cyberjak2k/micromake.github.io/docs/delta/2/2.md

---
title: 下部组装
---

## 0.注意事项

!!! warning "螺丝固定"
    螺丝固定打印件时，不要拧的过紧，以免拧坏打印件。

!!! info "嵌入螺母"
    部分打印件需借助烙铁压入<strong>滚花螺母</strong>：
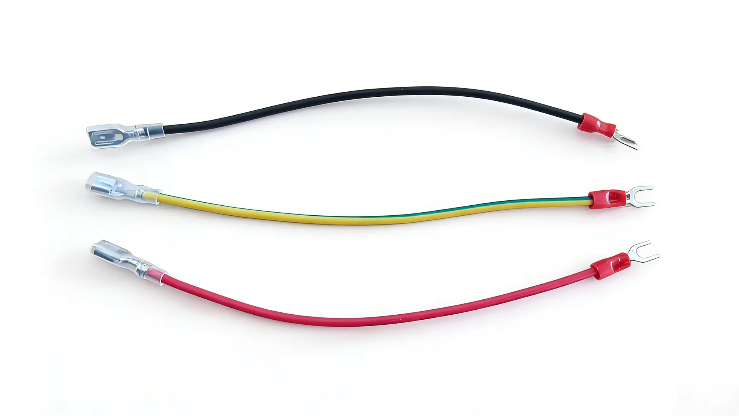
[picture p1: docs/delta/7/1.webp]
    

## 1.下装饰件

### 所需物料

1.脚垫 * 3
   

2.船型螺母20型-M3 * 6
   

3.M5*16 杯头螺丝 * 3
   

4.M3*10 杯头螺丝 * 6
   

### 打印零件

1.[下脚件装饰件] * 3
[下脚件装饰件]: dy1.stl
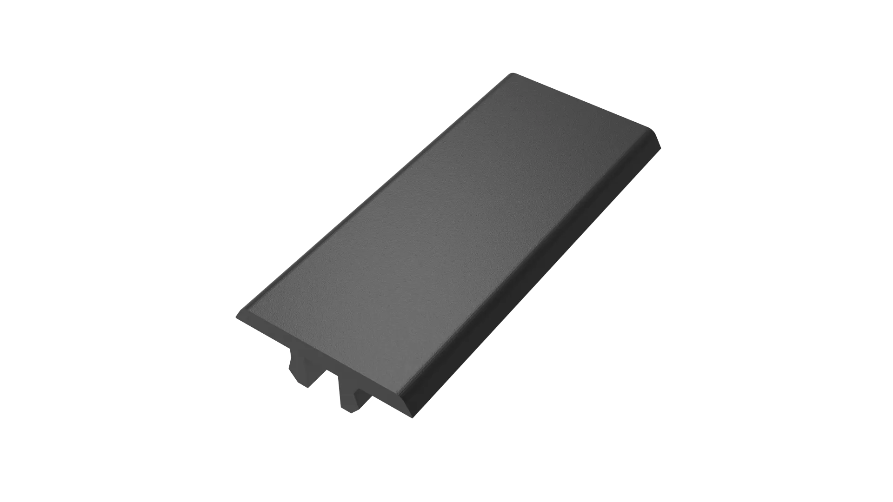
[picture p2: docs/delta/7/dy1.webp]
   

### 组装流程

1.将<strong>M5*16 杯头螺丝</strong>穿过<strong>脚垫</strong>拧入到<strong>下脚件装饰件</strong>中。
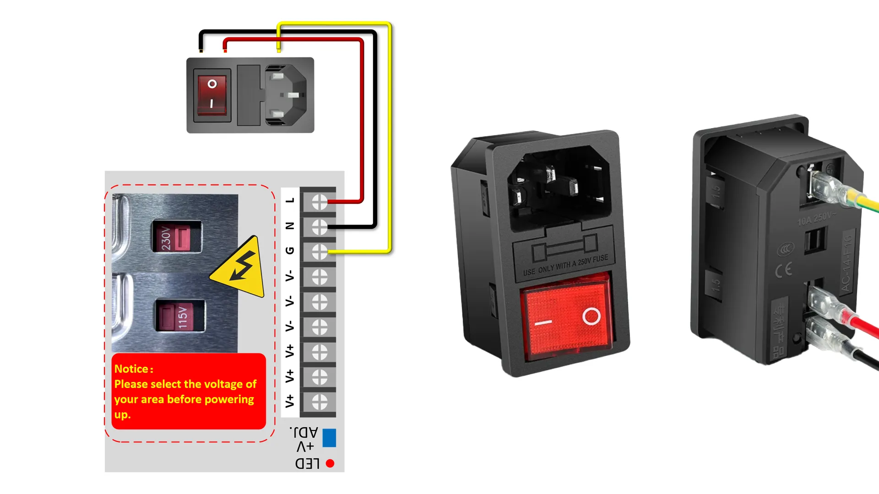
[picture p3: docs/delta/7/2.webp]
   

2.将<strong>M3*10 杯头螺丝</strong>穿过<strong>下脚件装饰件</strong>并套上<strong>船型螺母20型-M3</strong>。
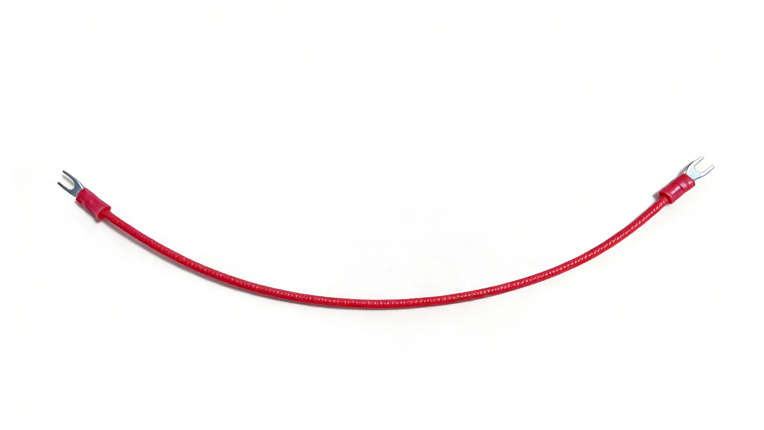
[picture p4: docs/delta/7/3.webp]
   

3.<strong>M3*10 杯头螺丝</strong>拧上即可，无需拧紧。
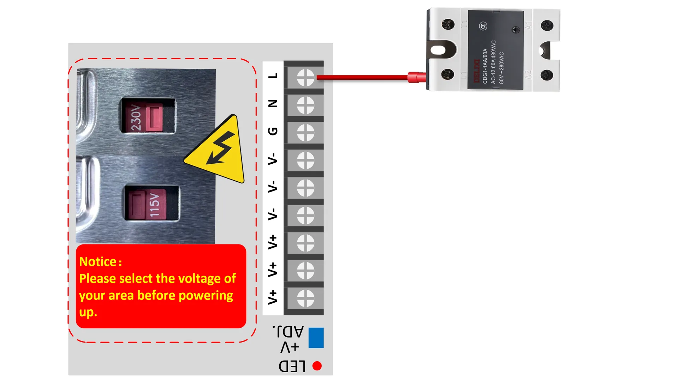
[picture p5: docs/delta/7/4.webp]
   

4.固定到<strong>短铝型材</strong>上。
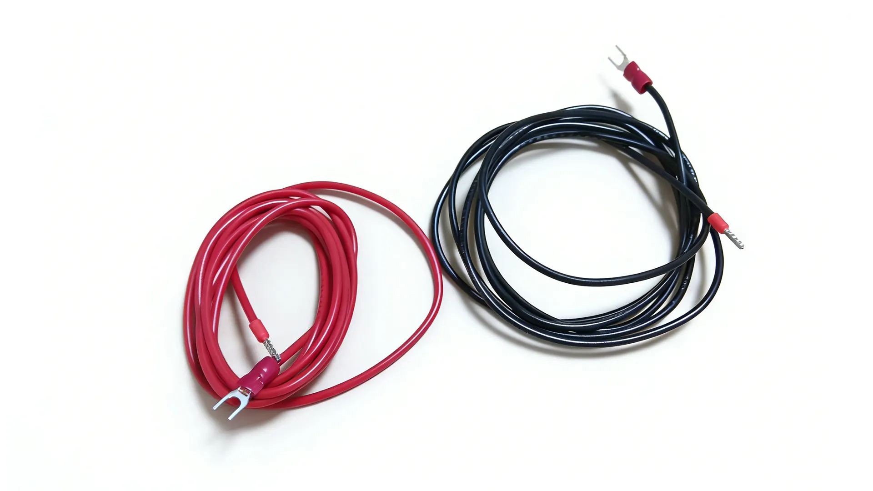
[picture p6: docs/delta/7/5.webp]
   

5.注意<strong>船型螺母20型-M3</strong>的位置，应卡在型材上，不要拧的过紧，以免拧坏<strong>下脚件装饰件</strong>。
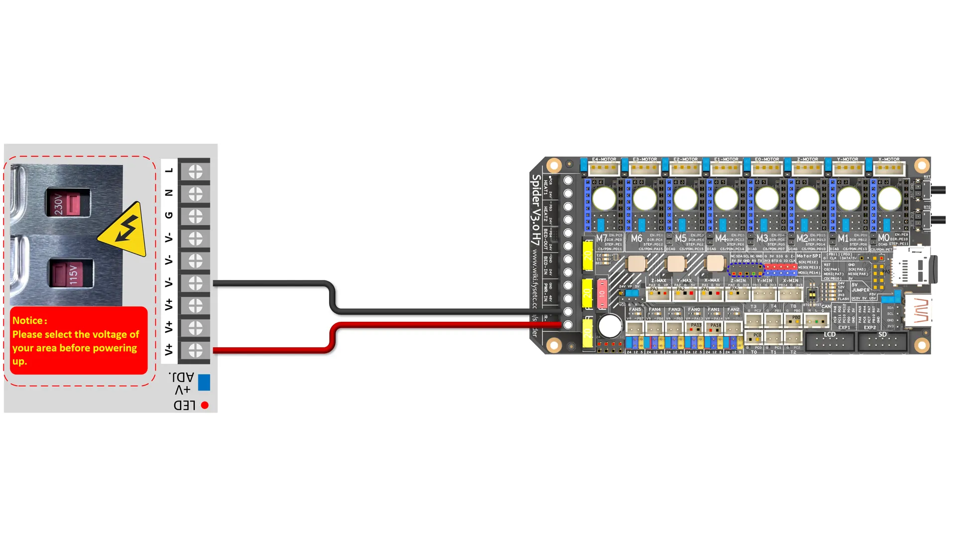
[picture p7: docs/delta/7/6.webp]
   

6.另外两组安装方法相同。
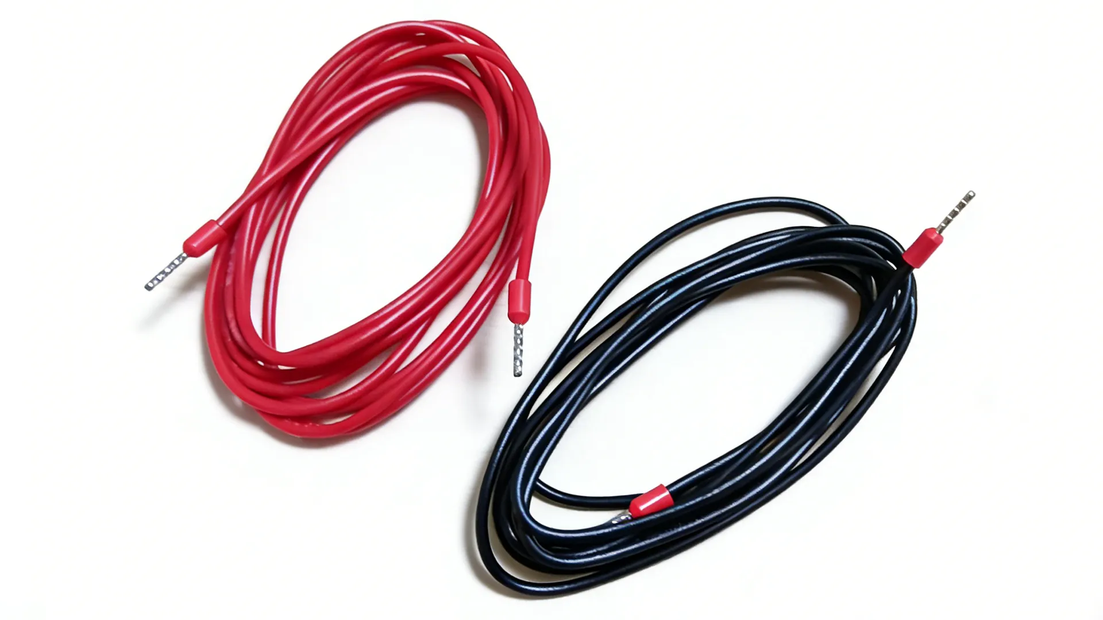
[picture p8: docs/delta/7/7.webp]
   

## 2.左侧裙边

### 所需物料

1.M3*8 沉头螺丝 * 6
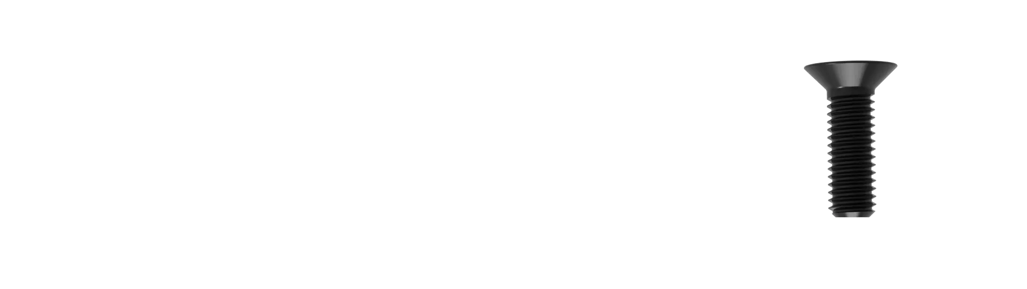
[picture p9: docs/delta/7/M3X8.webp]
   

2.滚花螺母 * 3
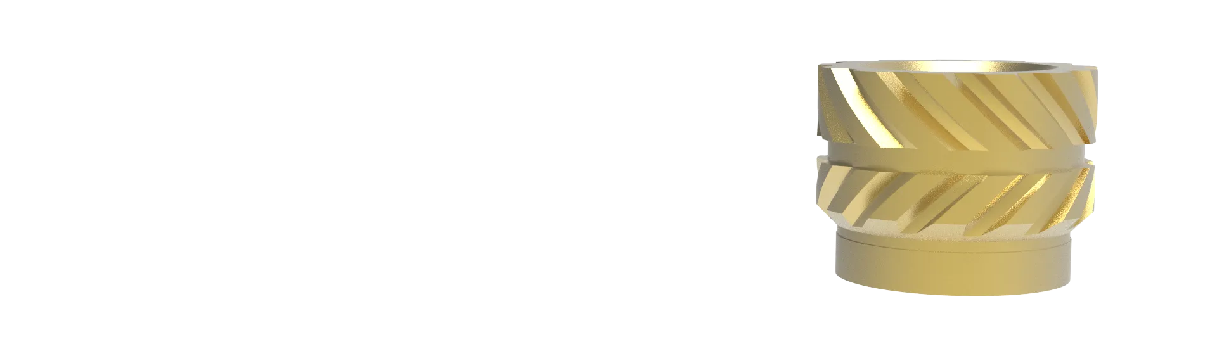
[picture p10: docs/delta/7/tlm.webp]
   
   
3.船型螺母20型-M3 * 6
   

### 打印零件

1.[左裙边打印件]  * 3
[左裙边打印件]: dy2.stl
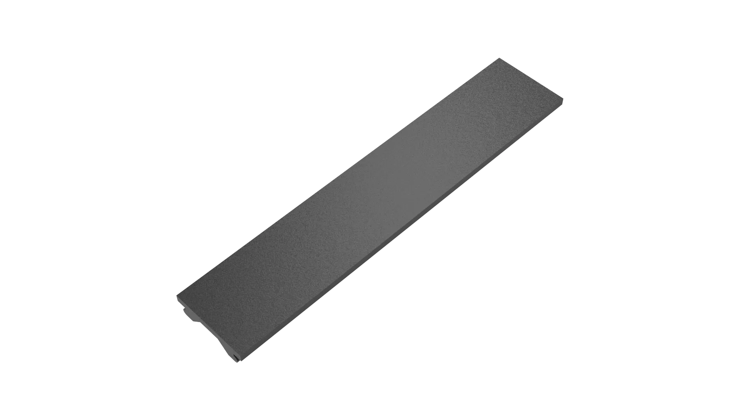
[picture p11: docs/delta/7/dy2.webp]
   

### 组装流程

1.使用烙铁将<strong>滚花螺母</strong>压入<strong>左裙边打印件</strong>中。
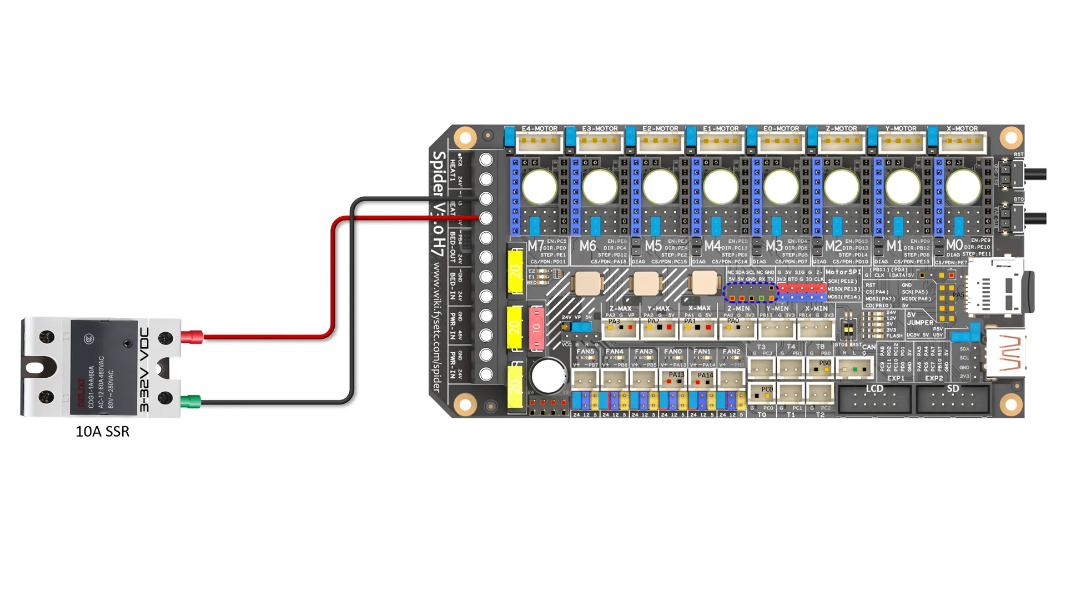
[picture p12: docs/delta/7/8.webp]
   

2.将<strong>M3*8 沉头螺丝</strong>穿过<strong>左裙边打印件</strong>并套上<strong>船型螺母20型-M3</strong>。
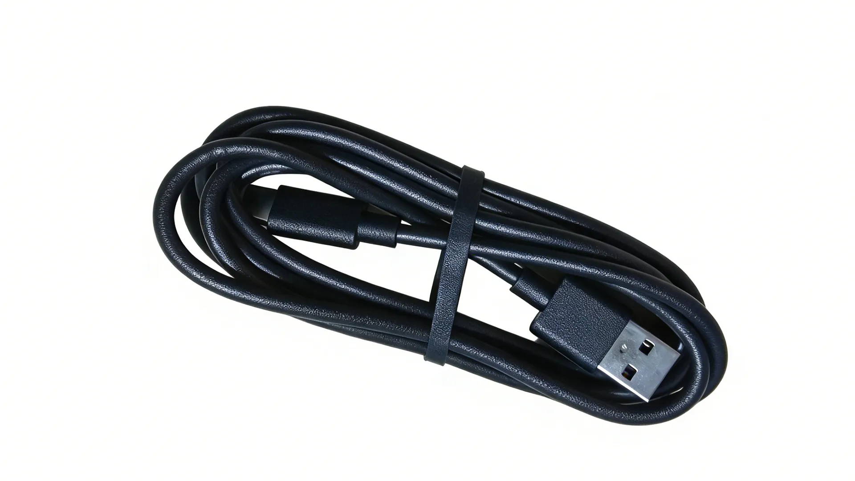
[picture p13: docs/delta/7/9.webp]
   

3.<strong>M3*8 沉头螺丝</strong>拧上即可，无需拧紧。
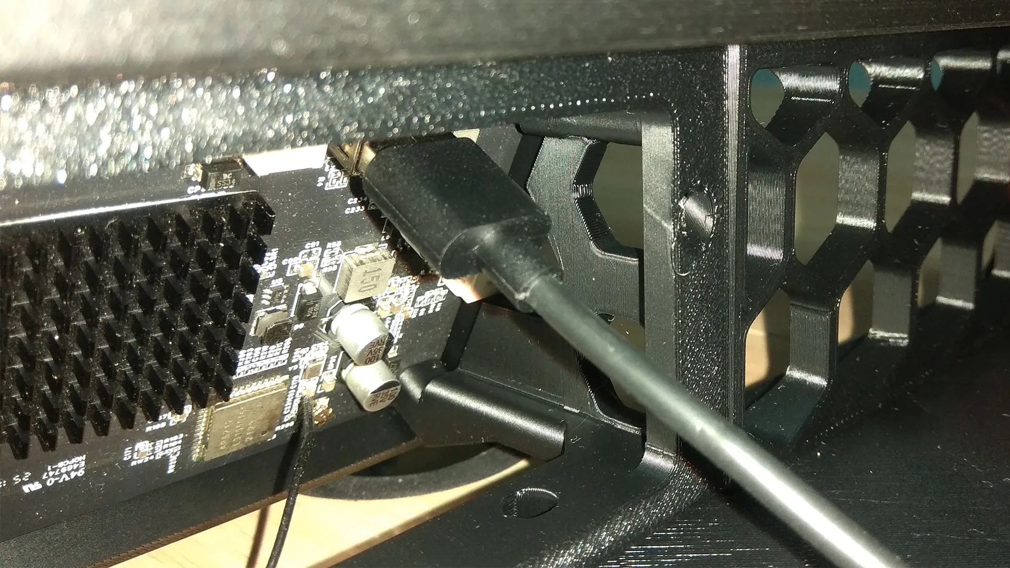
[picture p14: docs/delta/7/10.webp]
   

4.固定到<strong>短铝型材</strong>上。
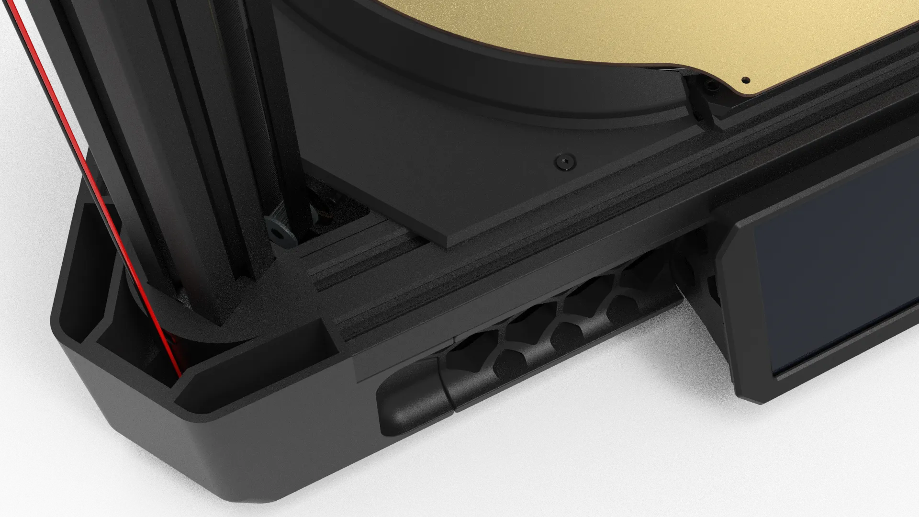
[picture p15: docs/delta/7/11.webp]
   

5.另外两组安装方法相同。
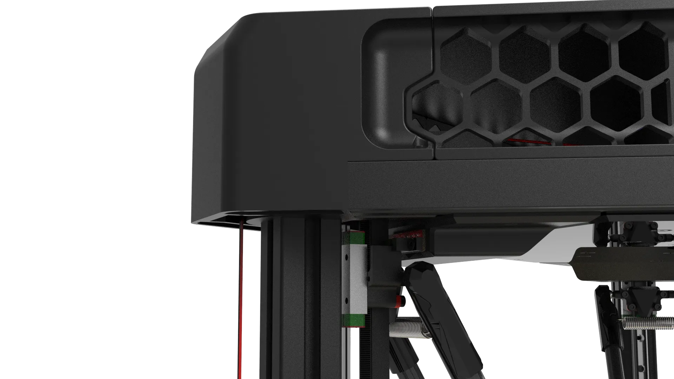
[picture p16: docs/delta/7/12.webp]
   
  
## 3.电源开关

### 所需物料

1.电源开关 * 1
   

2.M3*8 沉头螺丝 * 2
   

3.滚花螺母 * 1
   

4.船型螺母20型-M3 * 2
   

### 打印零件

1.[右裙边开关打印件] * 1
[右裙边开关打印件]: dy3.stl
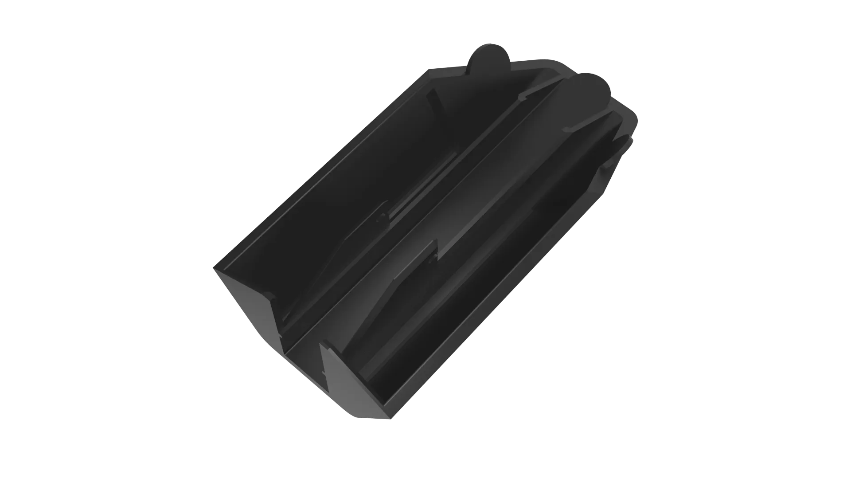
[picture p17: docs/delta/7/dy3.webp]
   

### 组装流程

1.使用烙铁将<strong>滚花螺母</strong>压入<strong>右裙边开关打印件</strong>中。
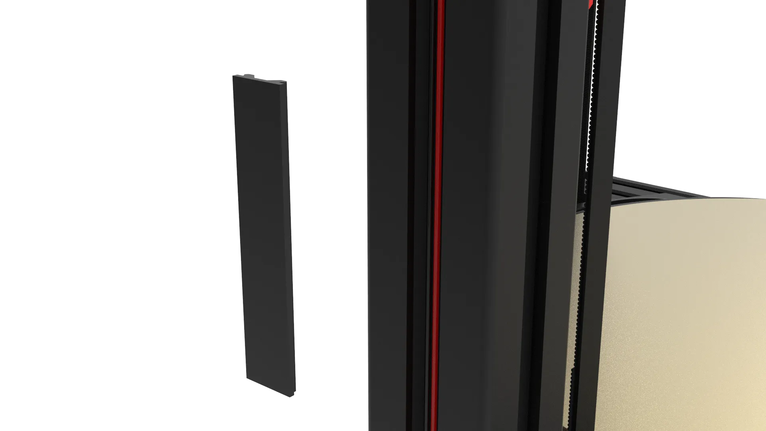
[picture p18: docs/delta/7/13.webp]
   

2.将<strong>电源开关</strong>装入<strong>右裙边开关打印件</strong>中。
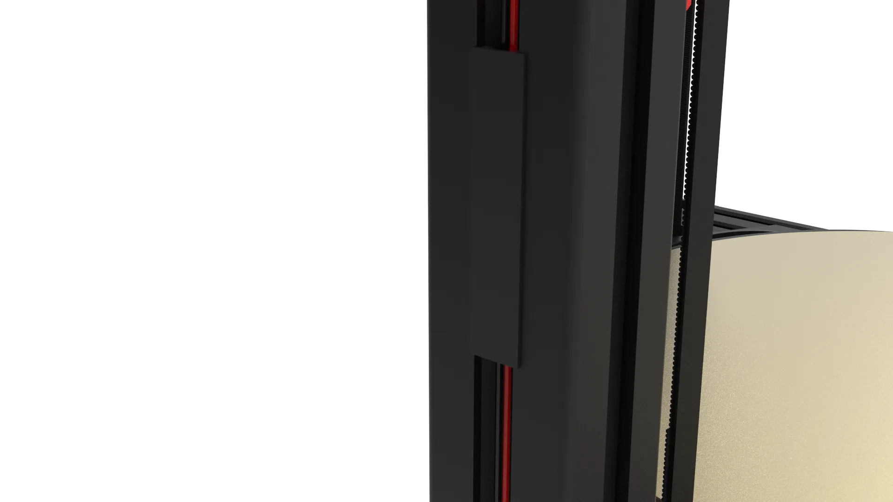
[picture p19: docs/delta/7/14.webp]
   

3.将<strong>M3*8 沉头螺丝</strong>穿过<strong>右裙边开关打印件</strong>并套上<strong>船型螺母20型-M3</strong>。
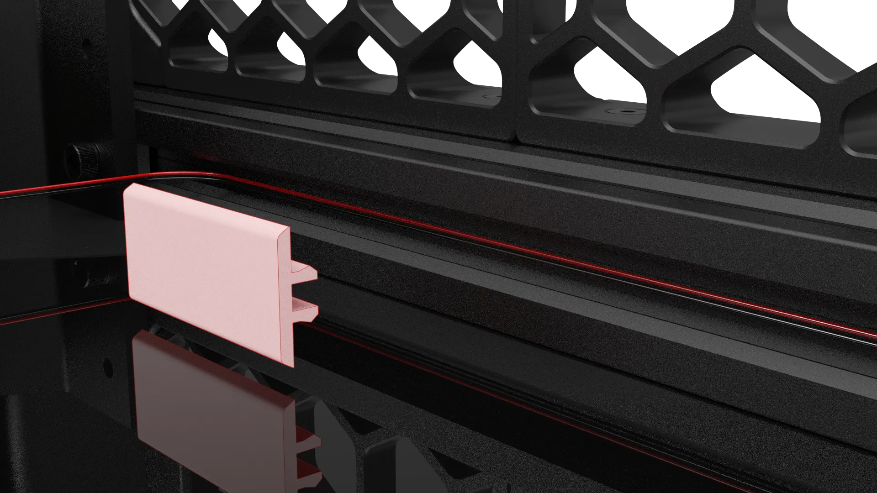
[picture p20: docs/delta/7/15.webp]
   

4.<strong>M3*8 沉头螺丝</strong>拧上即可，无需拧紧。
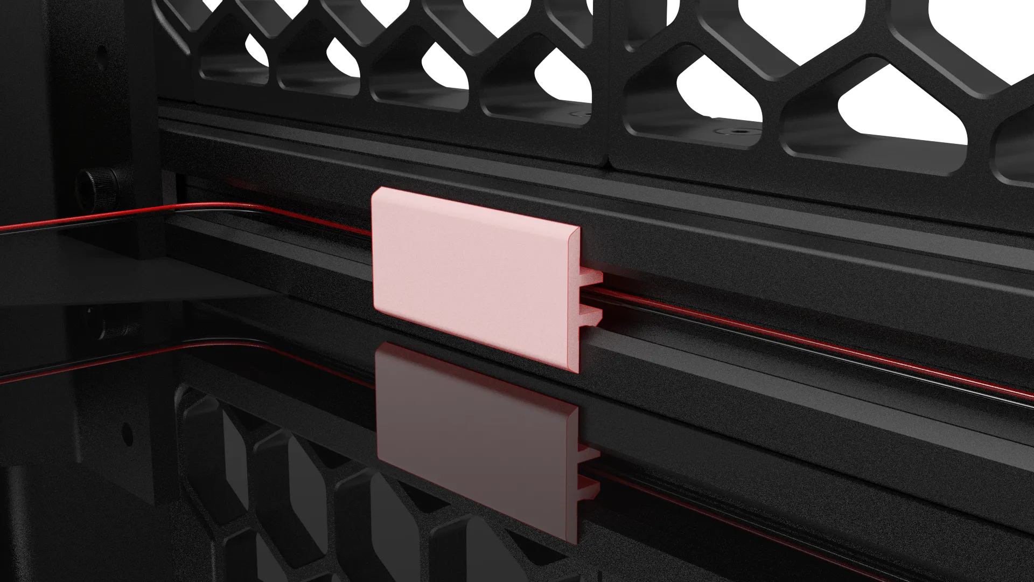
[picture p21: docs/delta/7/16.webp]
   

5.固定到<strong>短铝型材</strong>上。
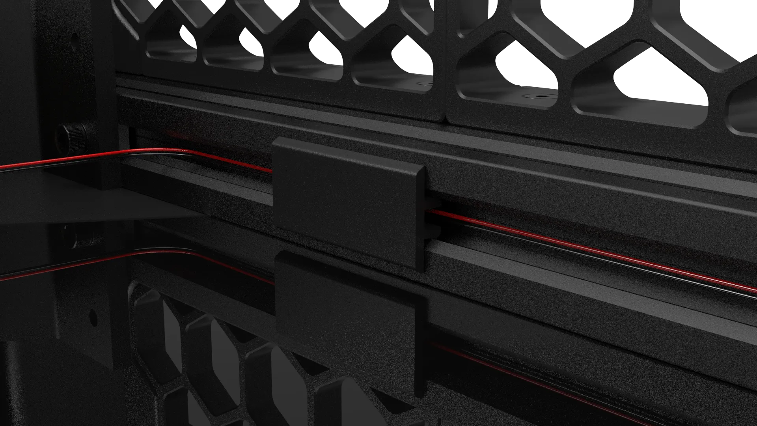
[picture p22: docs/delta/7/17.webp]
   

## 4.右侧裙边

### 所需物料

1.M3*8 沉头螺丝 * 4
   

2.滚花螺母 * 2
   

3.船型螺母20型-M3 * 4
   

### 打印零件

1.[右裙边打印件] * 2
[右裙边打印件]: dy4.stl
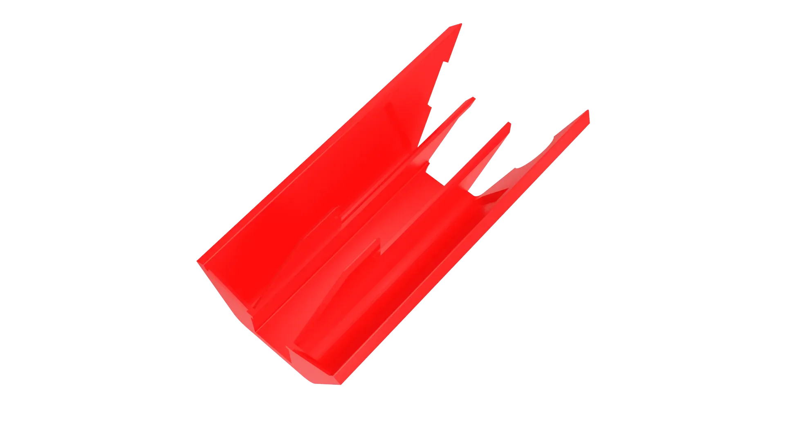
[picture p23: docs/delta/7/dy4.webp]
   

### 组装流程

1.使用烙铁将<strong>滚花螺母</strong>压入<strong>右裙边打印件</strong>中。
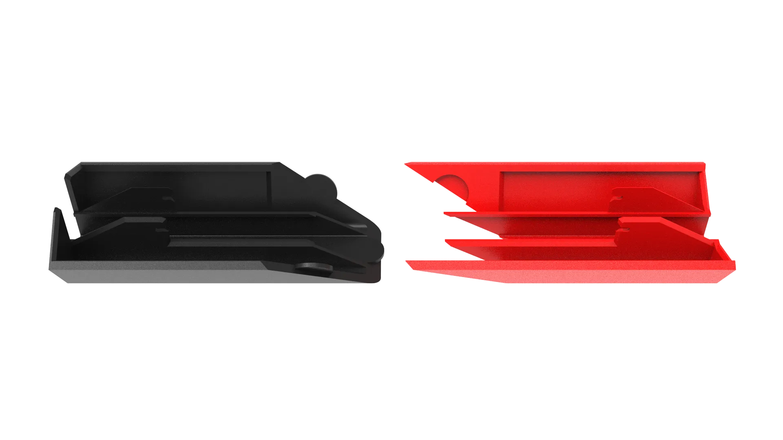
[picture p24: docs/delta/7/18.webp]
   

2.将<strong>M3*8 沉头螺丝</strong>穿过<strong>右裙边打印件</strong>并套上<strong>船型螺母20型-M3</strong>。
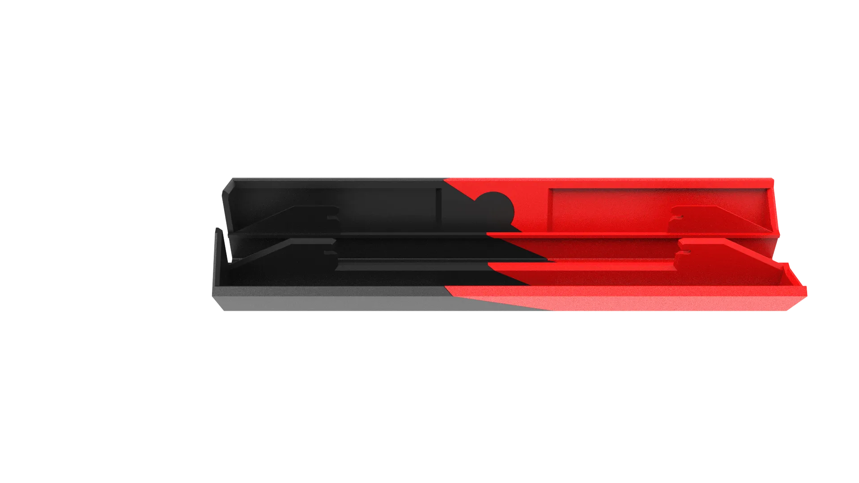
[picture p25: docs/delta/7/19.webp]
   

3.<strong>M3*8 沉头螺丝</strong>拧上即可，无需拧紧。
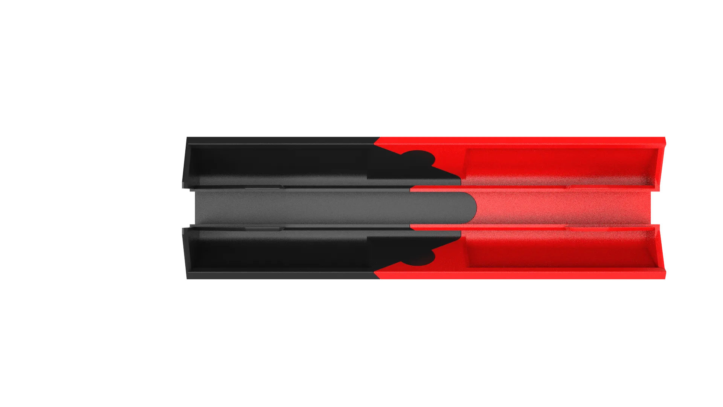
[picture p26: docs/delta/7/20.webp]
      

4.固定到<strong>短铝型材</strong>上。
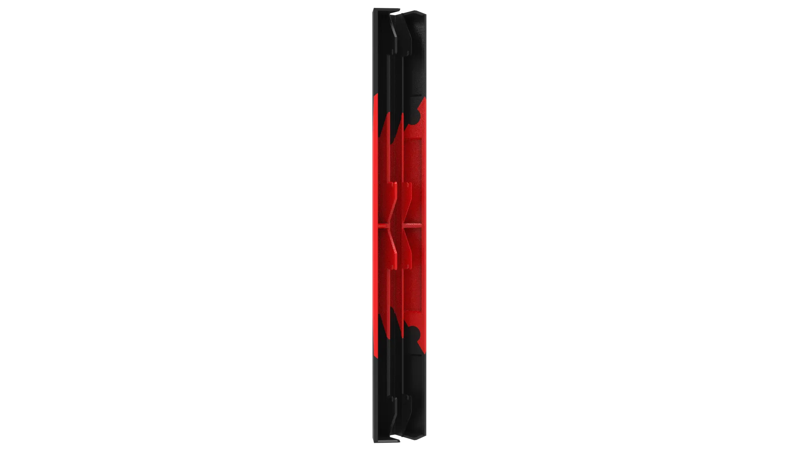
[picture p27: docs/delta/7/21.webp]
   

5.另外一组安装方法相同。
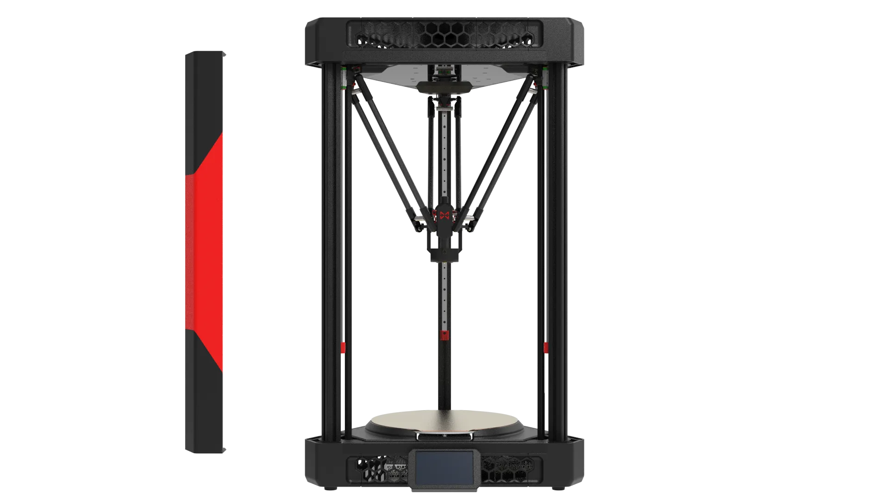
[picture p28: docs/delta/7/22.webp]
   

## 5.两侧裙边

### 所需物料

1.M3*8 沉头螺丝 * 4
   

2.滚花螺母 * 4
   

3.船型螺母20型-M3 * 4
   

### 打印零件

1.[中间裙边打印件] * 2
[中间裙边打印件]: dy5.stl
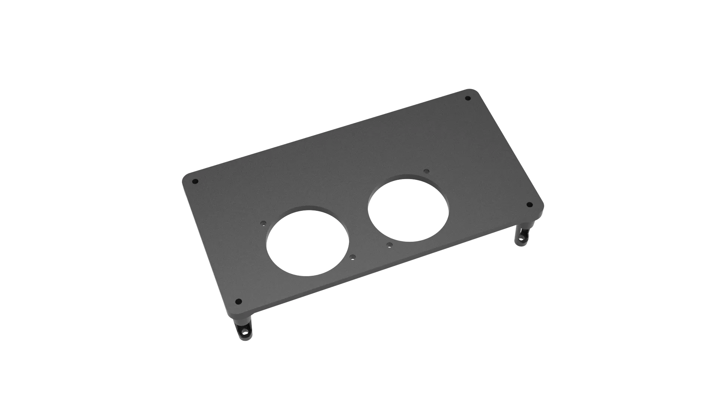
[picture p29: docs/delta/7/dy5.webp]
   

### 组装流程

1.使用烙铁将<strong>滚花螺母</strong>压入<strong>中间裙边打印件</strong>中。
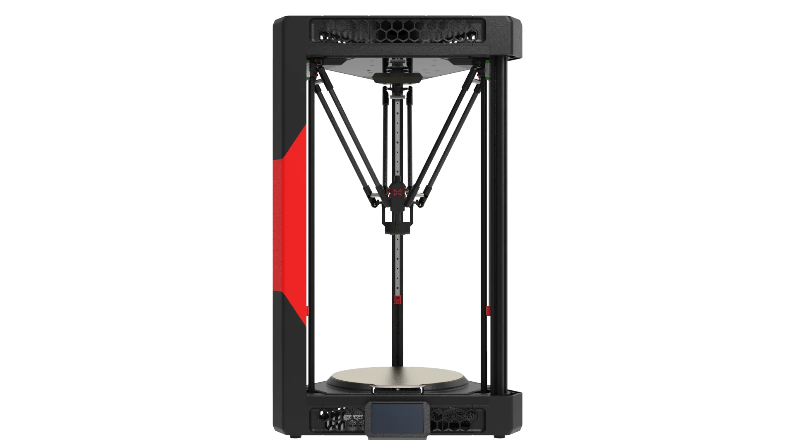
[picture p30: docs/delta/7/23.webp]
   

2.将<strong>M3*8 沉头螺丝</strong>穿过<strong>中间裙边打印件</strong>并套上<strong>船型螺母20型-M3</strong>。
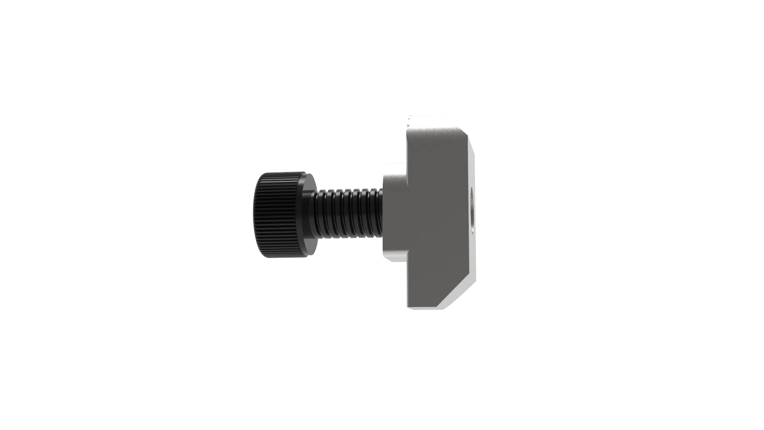
[picture p31: docs/delta/7/24.webp]
   

3.<strong>M3*8 沉头螺丝</strong>拧上即可，无需拧紧。
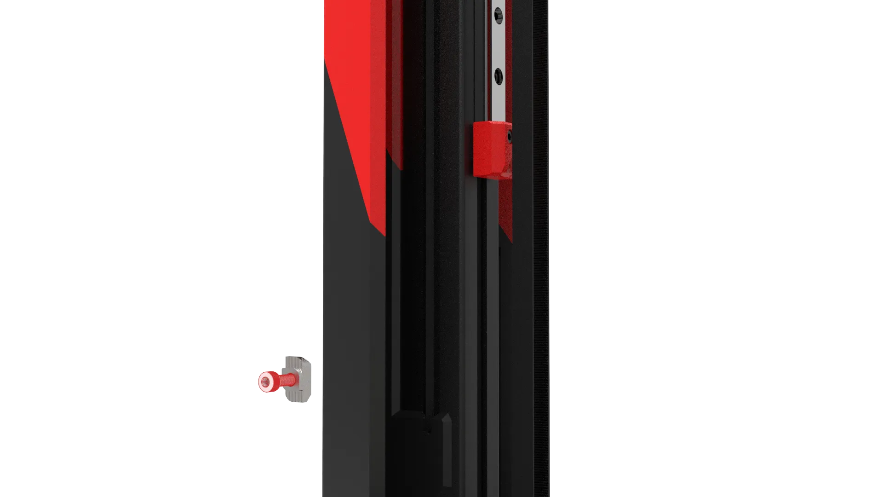
[picture p32: docs/delta/7/25.webp]
      

4.固定到<strong>短铝型材</strong>上。
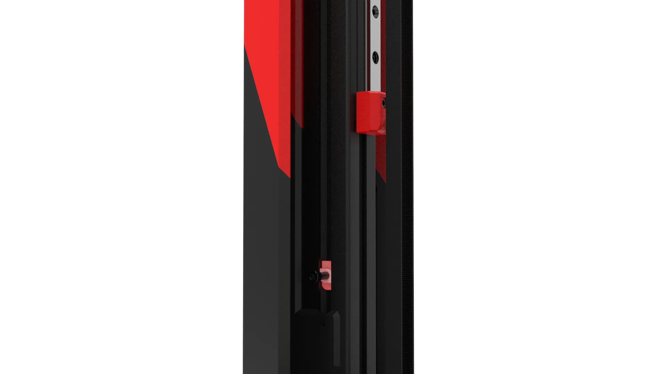
[picture p33: docs/delta/7/26.webp]
   

5.另外一组安装方法相同。
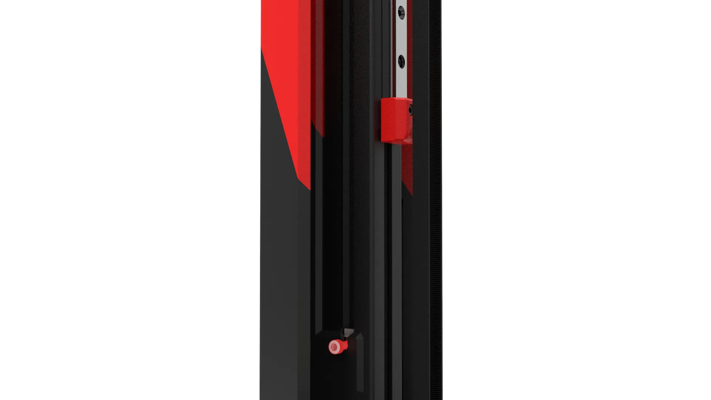
[picture p34: docs/delta/7/27.webp]
   

!!! info "注意开关的所在位置"
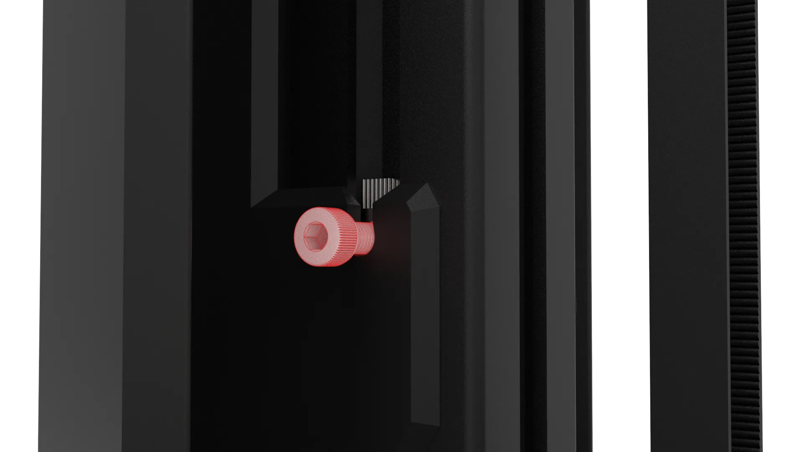
[picture p35: docs/delta/7/28.webp]
    

## 6.触摸屏幕

### 所需物料
1.触摸屏 * 1
   

2.M3*8 沉头螺丝 * 2
   

3.滚花螺母 * 2
   

4.船型螺母20型-M3 * 2
   

### 打印零件

1.[屏幕固定件] * 1
[屏幕固定件]: dy6.stl
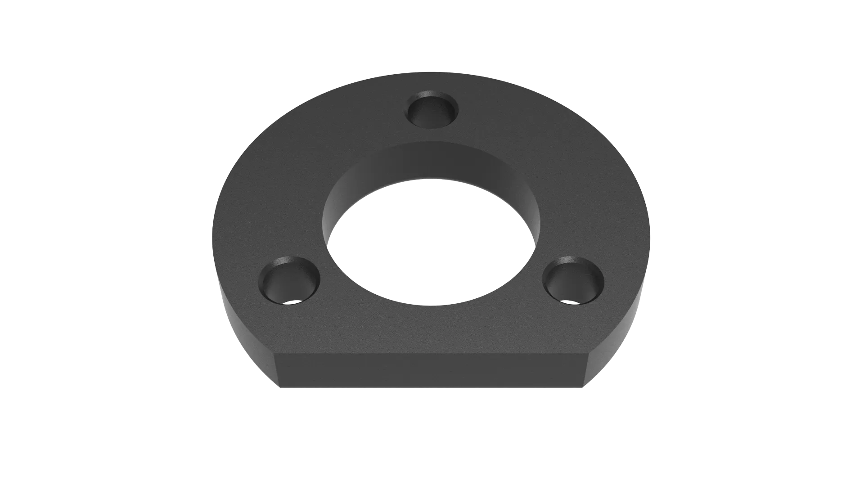
[picture p36: docs/delta/7/dy6.webp]
   
   
2.[屏幕前框] * 1
[屏幕前框]: dy7.stl
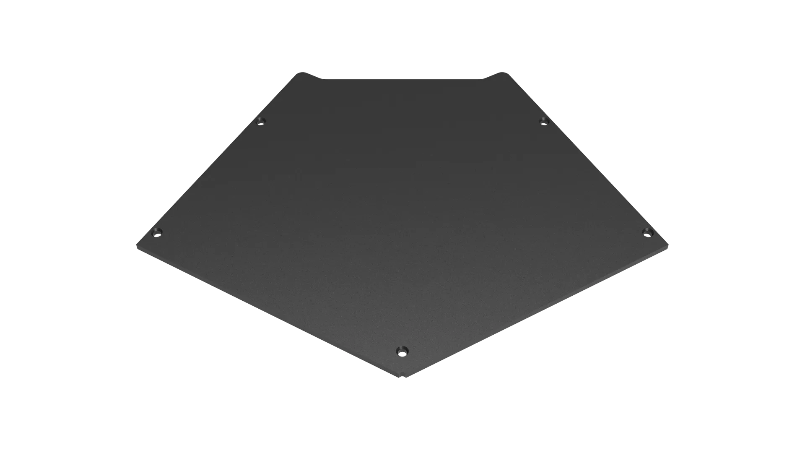
[picture p37: docs/delta/7/dy7.webp]
   

### 组装流程

1.使用烙铁将<strong>滚花螺母</strong>压入<strong>屏幕固定件</strong>中。
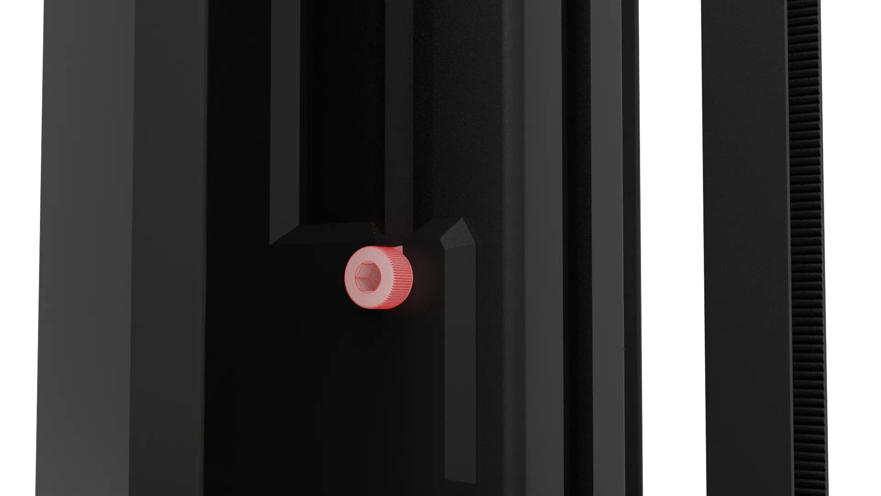
[picture p38: docs/delta/7/29.webp]
   

2.将<strong>M3*8 沉头螺丝</strong>穿过<strong>屏幕固定件</strong>并套上<strong>船型螺母20型-M3</strong>。
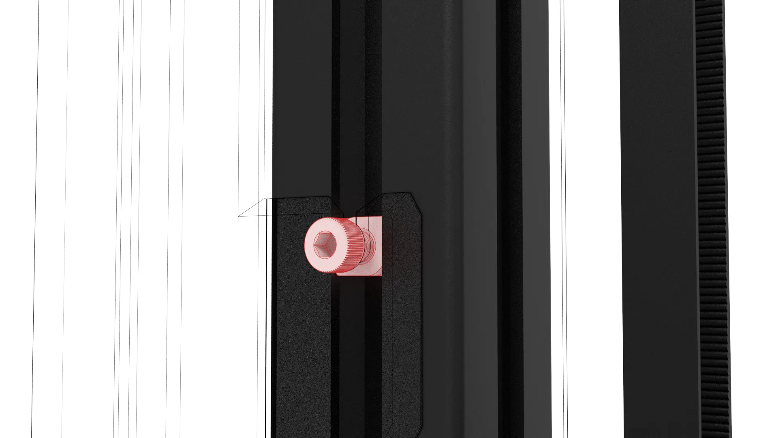
[picture p39: docs/delta/7/30.webp]
   

3.<strong>M3*8 沉头螺丝</strong>拧上即可，无需拧紧。
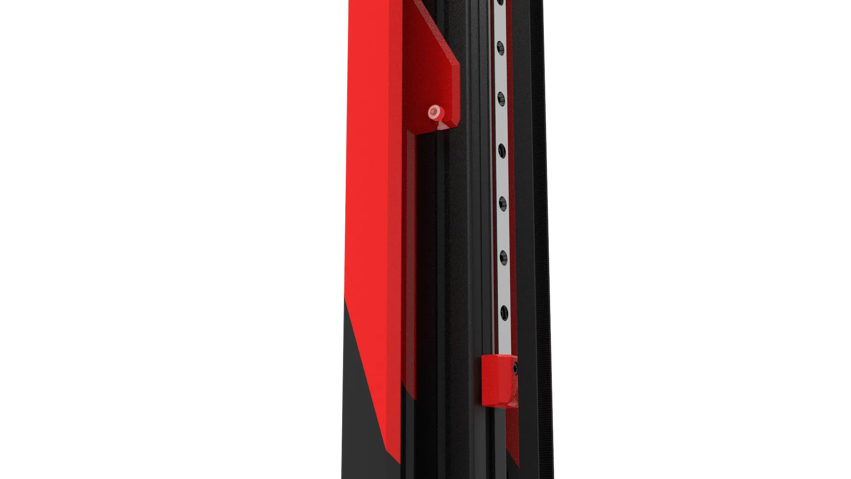
[picture p40: docs/delta/7/31.webp]
   

4.将<strong>触摸屏</strong>如图所示装入到<strong>屏幕固定件</strong>中。
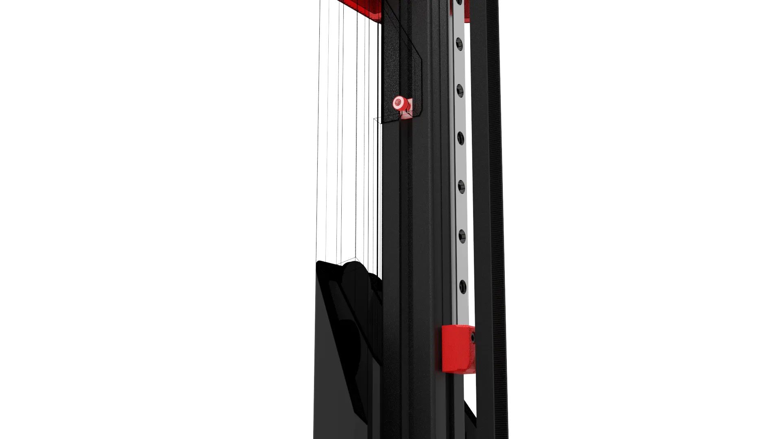
[picture p41: docs/delta/7/32.webp]
   

5.将<strong>屏幕前框</strong>扣入到屏幕上，注意角度，不要太过用力以免损坏屏幕。
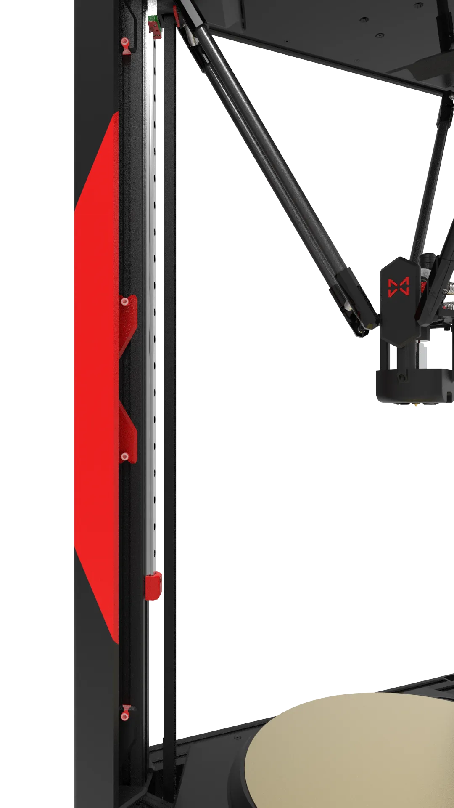
[picture p42: docs/delta/7/33.webp]
   
   
6.正确卡入时，<strong>屏幕前框</strong>应与<strong>屏幕固定件</strong>的卡扣相互扣合。
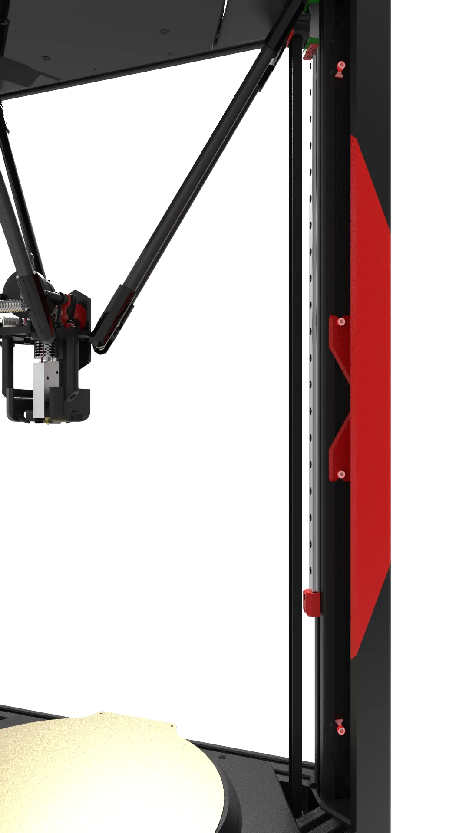
[picture p43: docs/delta/7/34.webp]
   

7.固定到<strong>短铝型材</strong>上。
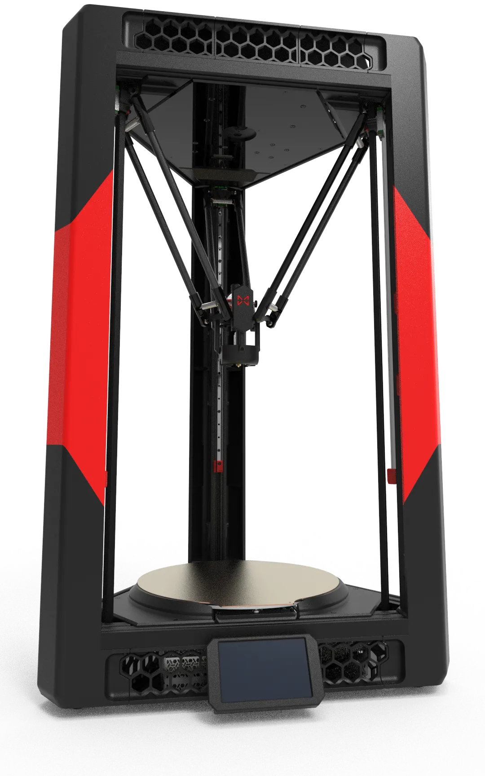
[picture p44: docs/delta/7/35.webp]
   

## 7.电器固定

### 所需物料
1.底部固定板 * 1
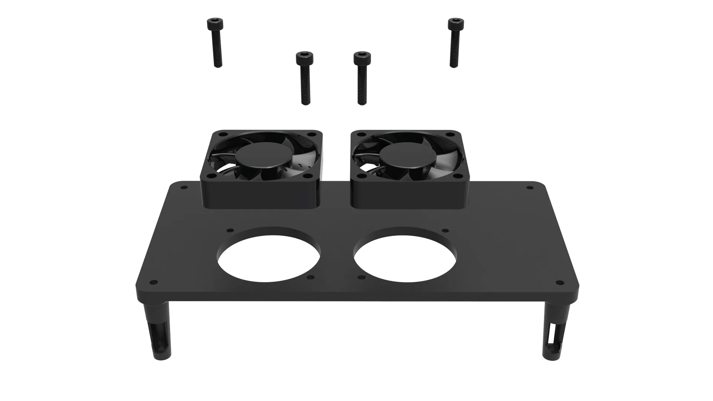
[picture p45: docs/delta/7/36.webp]
   

2.固态继电器 * 1
   

3.开关电源 * 1
   
   
4.M3*8 沉头螺丝 * 18
   

5.M3*10 杯头螺丝 * 2
   

6.M3自锁螺母 * 2
   

### 组装流程

1.将<strong>开关电源</strong>放置在<strong>底部固定板</strong>上，如图所示。
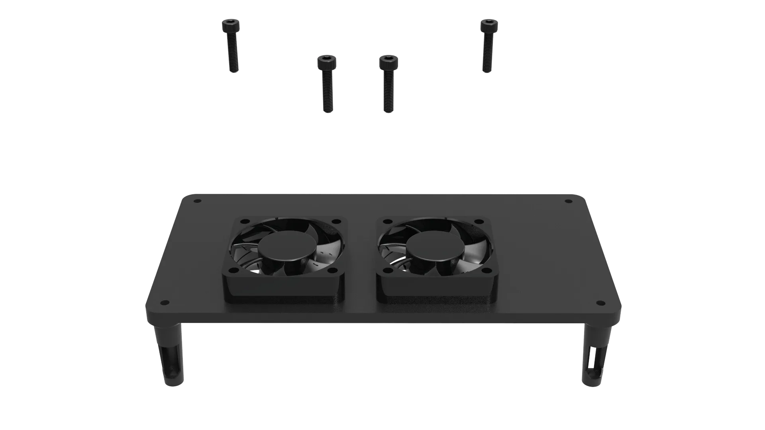
[picture p46: docs/delta/7/37.webp]
   
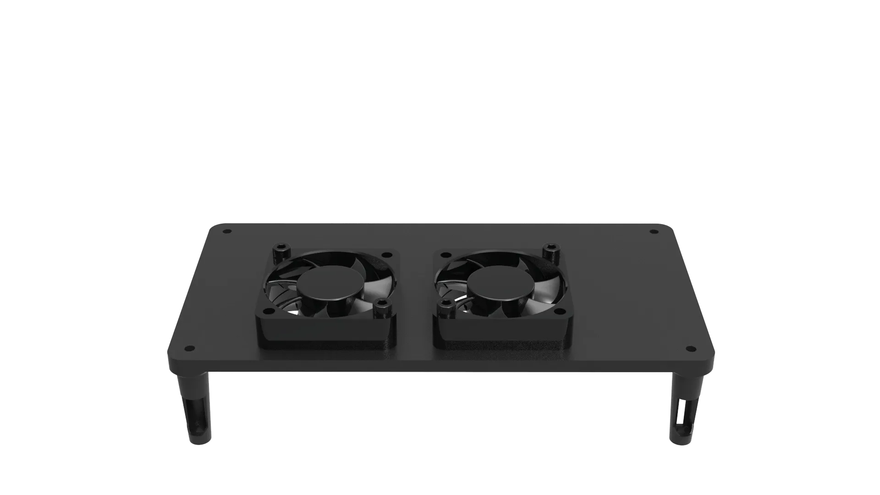
[picture p47: docs/delta/7/38.webp]
   

2.反转后，使用四颗<strong>M3*8 沉头螺丝</strong>进行固定，如图所示。
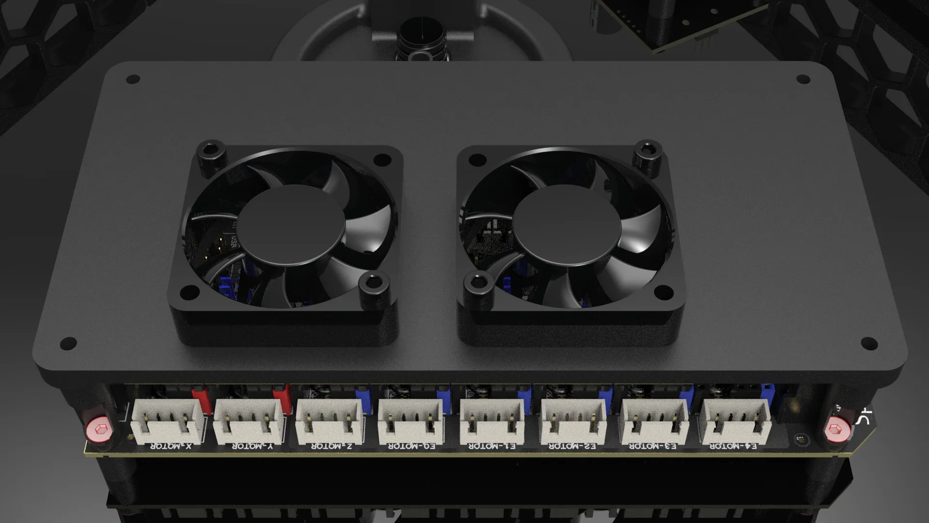
[picture p48: docs/delta/7/39.webp]
   

3.将<strong>固态继电器</strong>放置在<strong>电器固定盖板</strong>上，如图所示。
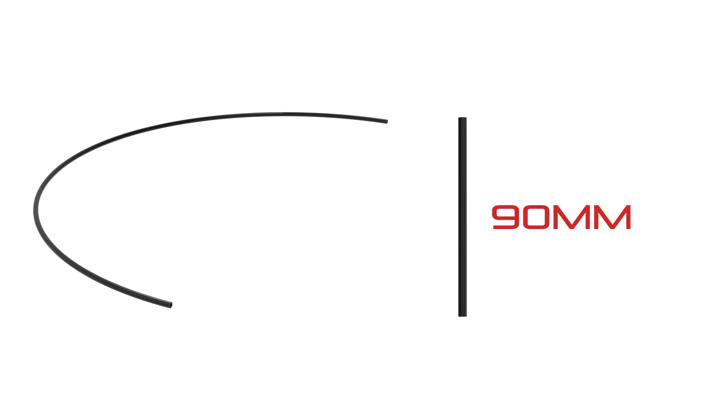
[picture p49: docs/delta/7/40.webp]
   

4.注意<strong>固态继电器</strong>的标识，如图所示。
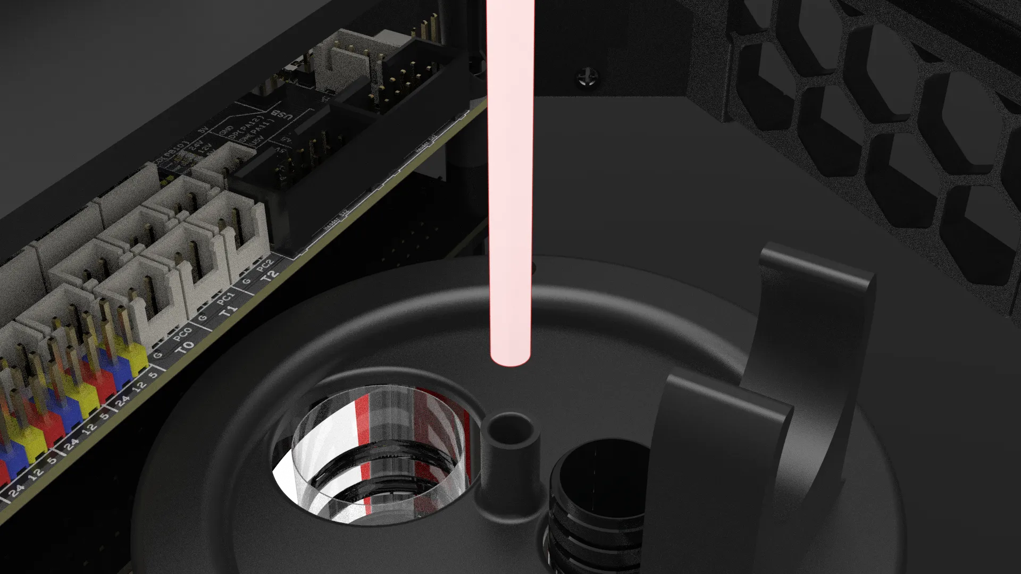
[picture p50: docs/delta/7/41.webp]
   

5.使用两颗<strong>M3*10 杯头螺丝</strong>穿过螺丝孔位。
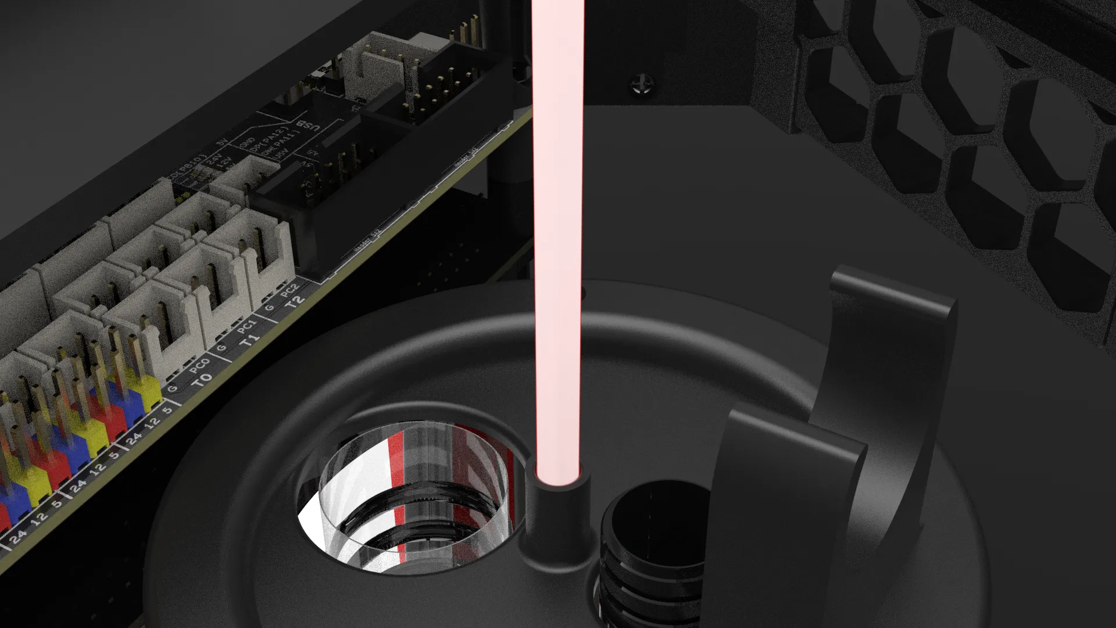
[picture p51: docs/delta/7/42.webp]
   
      
6.反转后使用两颗<strong>M3自锁螺母</strong>进行固定。
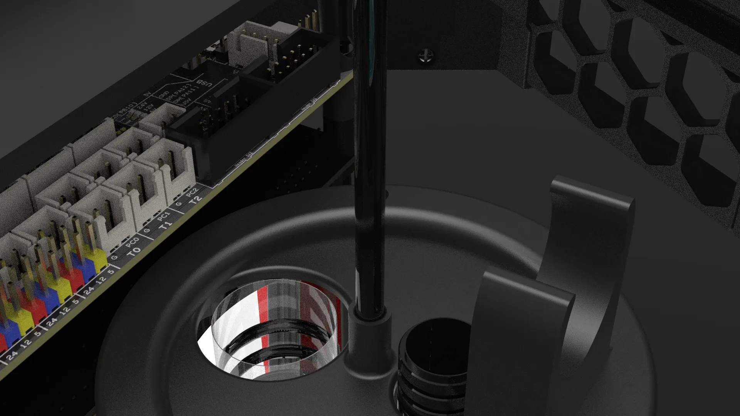
[picture p52: docs/delta/7/43.webp]
   
   
7.使用十二颗<strong>M3*8 沉头螺丝</strong>固定到底部。
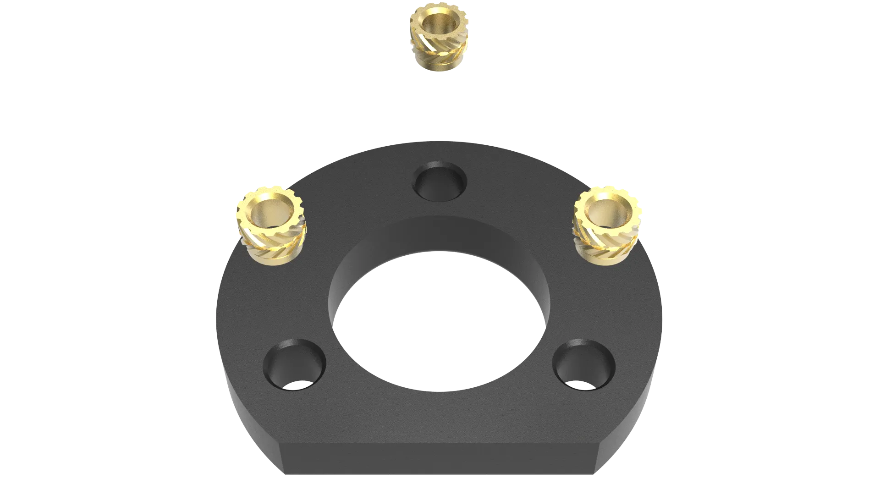
[picture p53: docs/delta/7/44.webp]
   

8.完成后后反转打印机，注意此时<strong>触摸屏</strong>朝前，<strong>开关电源</strong>与<strong>固态继电器</strong>应该右前侧。
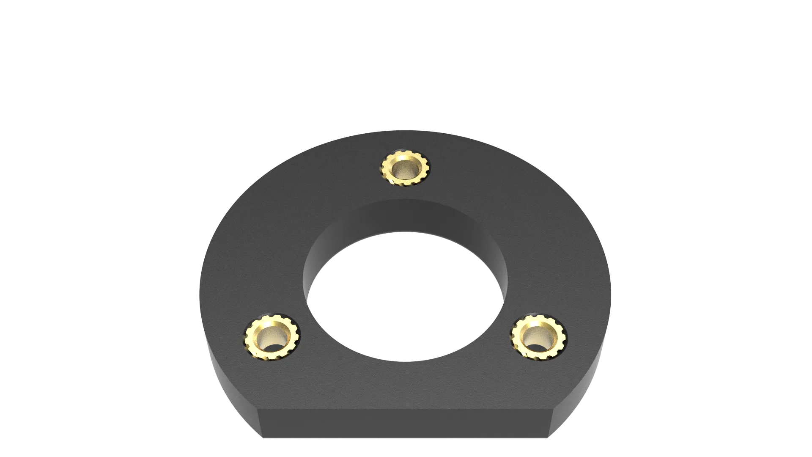
[picture p54: docs/delta/7/45.webp]
   

???- tip "预留扩展"
    底部预留的四个孔位可安装第二个高压电源，适配MW与MORNSUN的螺丝孔位，安装方法相同。
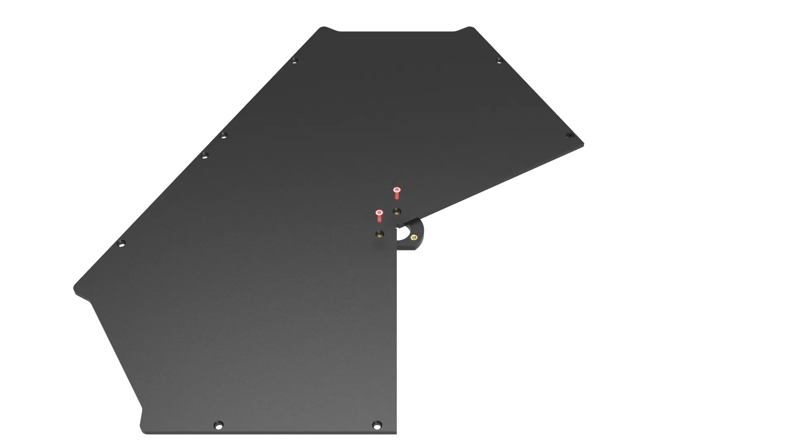
[picture p55: docs/delta/7/46.webp]
    

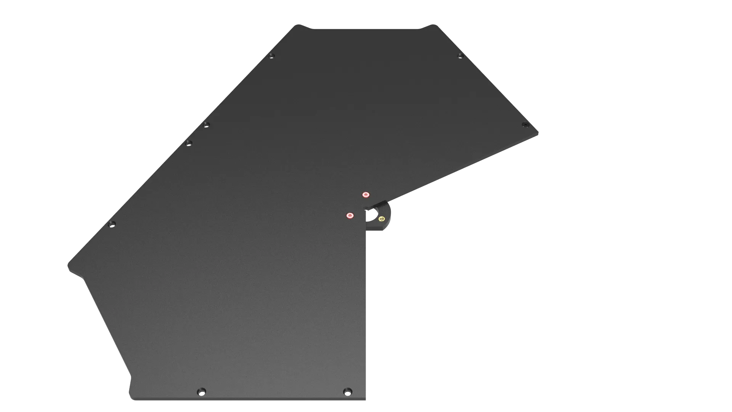
[picture p56: docs/delta/7/47.webp]


???- faq "FAQ"

    **Q: 裙边与Voron是否兼容？**

    **A:** 是的，裙边打印件与Voron 3D打印机是兼容的，也可以安装到其他Voron风格的开源3D打印机上。

    **Q: 触摸屏可以装到Voron上么？**

    **A:** 是的，触摸屏与Voron 3D打印机是兼容的，也可以安装到其他任何使用2020铝型材的3D打印机上。

    **Q: 打印件放在框架下面晃动会影响打印精度么？**

    **A:** 不会，刚性骨架承重、柔性、易换件做功能与安装面，在高速、高温、高加速度场景下，稳定性、精度、维护性全面占优，避免打印件长期受力蠕变、高温软化导致框架失稳、平面度变差，金属框架高强度连接保证高温、震动下几乎永不松脱，打印件在下可减震、降噪、不共振，避免金属直接硬接触导致的高频振纹、层纹、边角拉丝问题，同时打印件自由度高可扩展可改装，所有打印件均能本机自己打印。
