cyberjak2k/micromake.github.io/docs/delta/7/7.md

---
title: 线路连接
---

## 0.线路连接

!!! warning "警告"

    接线过程中请勿带电操作，会对您的人身安全的造成损害。

    详细对照接线图进行接线，尤其注意供电线路，接线错误会造成不可逆的电器损坏。

!!! info "接线图"
    点击查看完整[<strong>接线图</strong>]。
    [<strong>接线图</strong>]: jxt.pdf

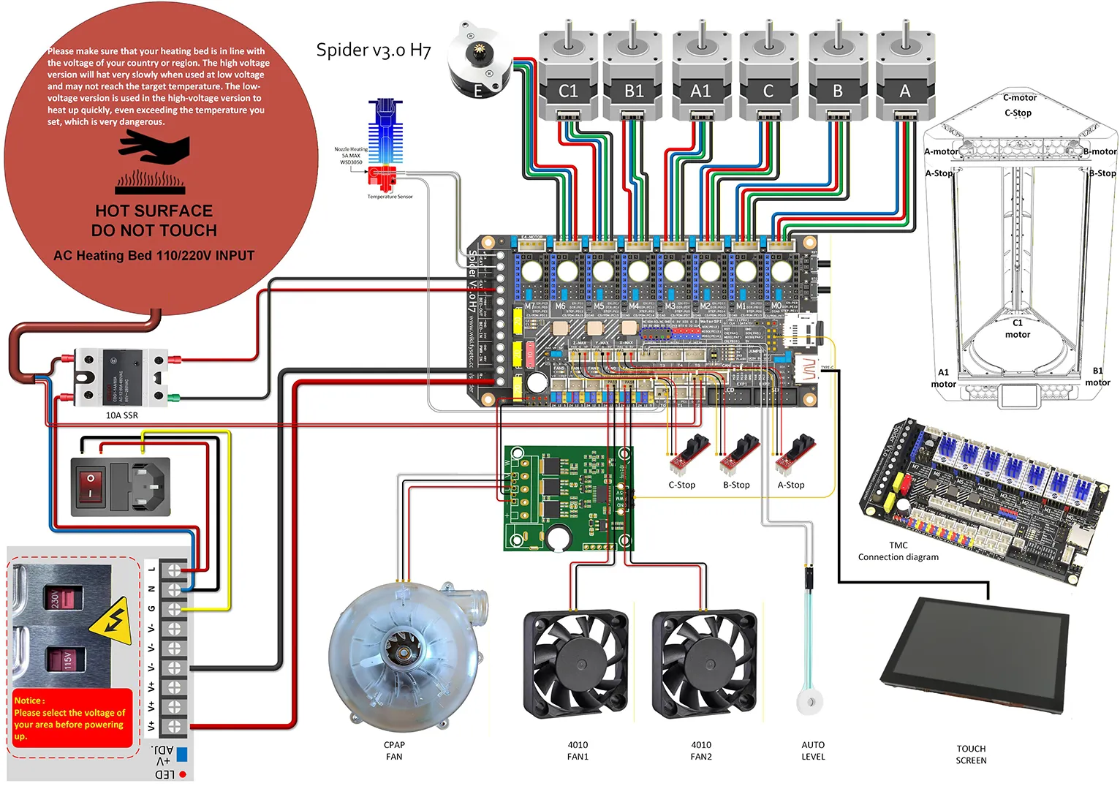
[picture p57: docs/delta/7/wzjxt.webp]
    

## 1.接线说明

### 开关电源

1.电源开关线：
   

2.接线说明：
   

### 耐高温线

1.耐高温线：
   

2.接线说明：
   

### 粗红黑线

1.粗红黑线：
   

2.接线说明：
   

### 细红黑线

1.细红黑线：
   

2.接线说明：
   

### TYPE-C线

1.TYPE-C线：
   

2.接线说明：
   

## 2.线材整理

### 所需物料

1.扎带
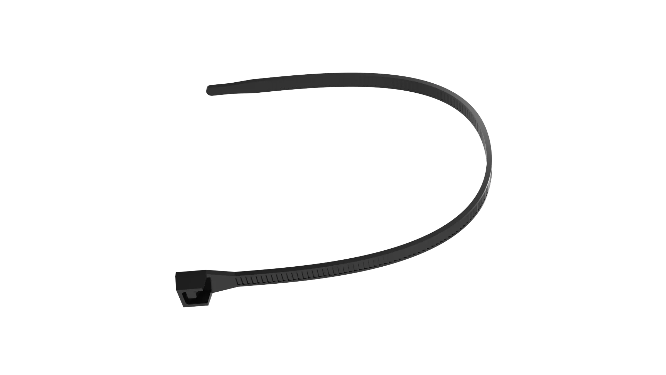
[picture p58: docs/delta/7/zd.webp]
   

### 打印零件

1.[2020型材卡扣]
[2020型材卡扣]: dy1.stl
   

2.[3030型材卡扣]
[3030型材卡扣]: dy2.stl
   

### 组装流程

1.将<strong>热床</strong>卡入<strong>后侧热床挡板</strong>的凹槽中，进行接线操作，使用<strong>扎带</strong>整理线材并剪去多余部分,如图所示。
   

2.将线穿过<strong>下脚件装饰件</strong>过线孔中并从上拉出，再穿入<strong>下脚件装饰件</strong>过线孔中并从<strong>步进电机</strong>处拉出，如图所示。
   
   

3.使用<strong>3030型材卡扣</strong>将线卡入到<strong>长铝型材</strong>上，如图所示。
   
   

4.使用<strong>2020型材卡扣</strong>将线卡入到<strong>长铝型材</strong>上，如图所示。
   
   
   

!!! info "打印数量"
    <strong>3030型材卡扣</strong>与<strong>2020型材卡扣</strong>的打印数量与长度根据喜好决定，一般线材不杂乱即可，可在切片软件中根据自己理线需求，修改打印文件件的长度。

## 3.挡边组装

### 所需物料

1.M4*10 杯头螺丝 * 24
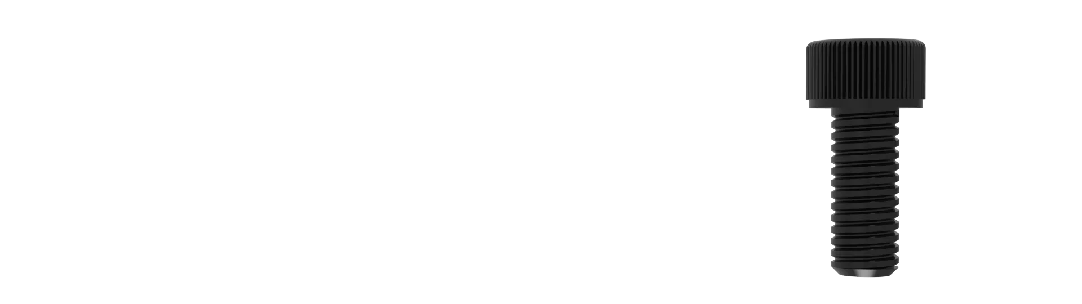
[picture p59: docs/delta/7/M4X10.webp]
   

2.船型螺母30型-M4 * 24
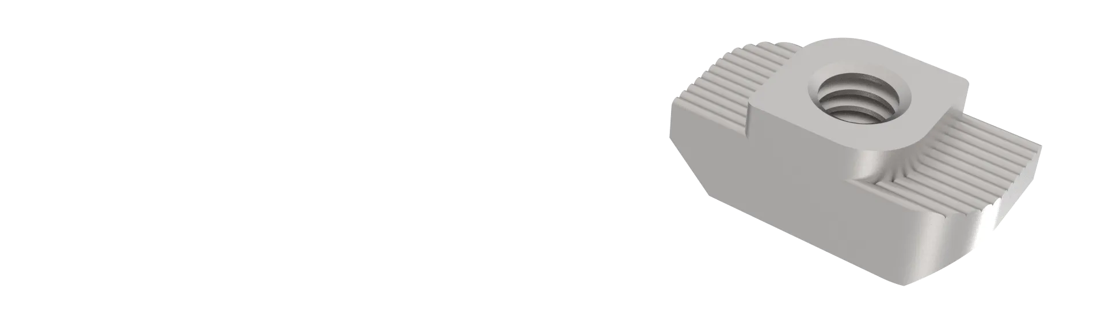
[picture p60: docs/delta/7/30M4.webp]
   

### 打印零件

1.[上下挡边] * 6
   [上下挡边]: dy3.stl
   

2.[中间挡边] * 6
   [中间挡边]: dy4.stl
   

### 组装流程

1.将<strong>上下挡边</strong>与<strong>中间挡边</strong>进行扣合，注意此结构为榫卯结构，圆形卡扣需全部卡入圆形凹槽中，如图所示。
   
   
   

2.使用相同方法再扣合一组，如图所示摆放。
   

3.扣入到<strong>长铝型材</strong>中，如图所示。
   
   

4.将<strong>M4*10 杯头螺丝</strong>拧入<strong>船型螺母30型-M4</strong>，不要拧紧，拧上即可，如图所示。
   

5.将螺丝放入<strong>长铝型材</strong>的卡槽中，向下滑动螺丝使能卡入<strong>上下挡边</strong>的槽中，拧好螺丝，如图所示。
   
   
   
   
   

!!! warning "注意"
    注意<strong>船型螺母40型-M4</strong>的位置，应卡在<strong>长型材的</strong>凹槽内，不要拧的过紧，以免拧坏打印件。
       

6.相同方法，螺丝放入<strong>长铝型材</strong>的卡槽中，向上滑动螺丝使能卡入<strong>中间挡边</strong>的槽中，拧好螺丝，如图所示。
   

!!! warning "注意"
    注意<strong>船型螺母40型-M4</strong>的位置，应卡在<strong>长型材的</strong>凹槽内，不要拧的过紧，以免拧坏打印件。
       

7.另外两颗螺丝安装方法相同，如图所示。
   

8.另外一边安装方法相同，如图所示。
   

9.另外两组安装相同，如图所示。
   

!!! info "配色参考"

    可根据你的喜好，自定义外观:
    
    

## 4.风扇组装

### 所需物料

1.4010散热风扇 * 2
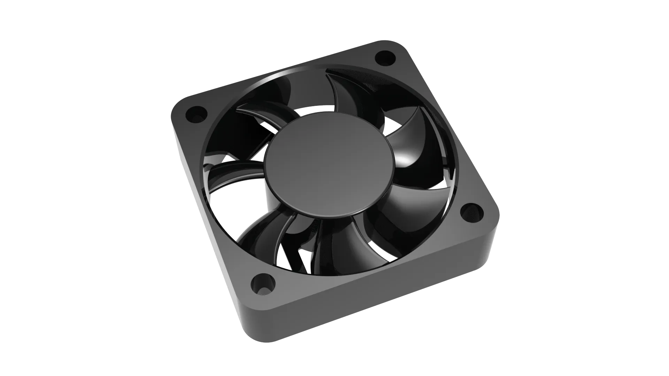
[picture p61: docs/delta/7/fan.webp]
   

2.M3*14 杯头螺丝 * 4
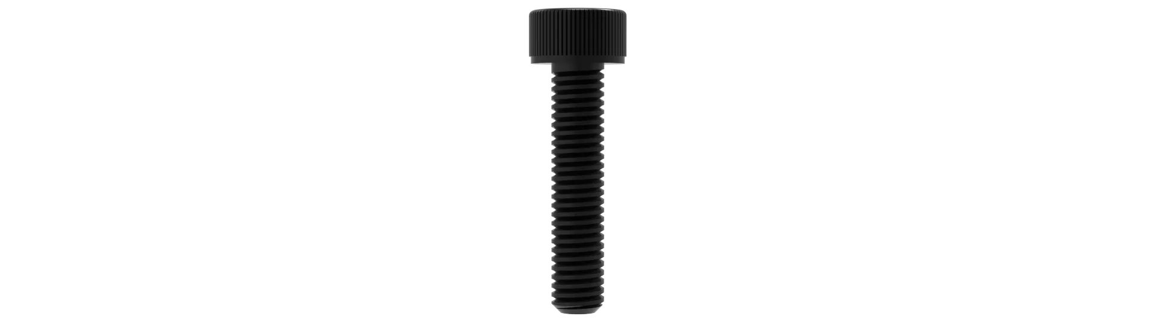
[picture p62: docs/delta/7/m3-14.webp]
   

### 打印零件

1.[风扇支架] * 1
   [风扇支架]: dy5.stl
   

### 组装流程

1.将四颗<strong>M3*14 杯头螺丝</strong>穿过<strong>4010散热风扇</strong>拧到<strong>风扇支架</strong>上，不要拧的过紧，以免拧坏打印件，如图所示。
   
   
   

2.将<strong>风扇支架</strong>固定到<strong>下位机主板</strong>上，如图所示。
   

## 5.盖板组装

### 所需物料

1.四氟管 * 1
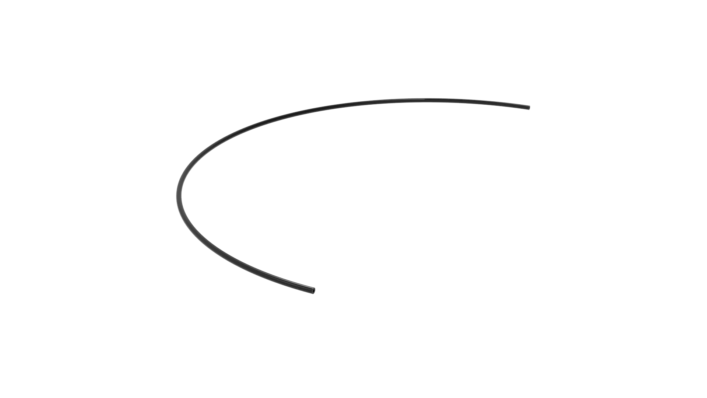
[picture p63: docs/delta/7/sfg.webp]
   

2.M3*8 沉头螺丝 * 4
   

3.滚花螺母 * 3
   

### 打印零件

1.[盖板连接件] * 1
   [盖板连接件]: dy6.stl
   

2.[盖板打印件] * 3
   [盖板打印件]: dy7.stl
   

3.[耗材支架] * 3
   [耗材支架]: dy8.stl
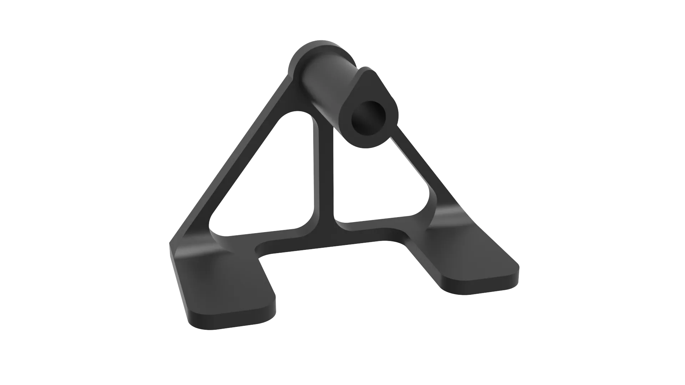
[picture p64: docs/delta/7/dy8.webp]
   

### 组装流程

1.将<strong>四氟管</strong>裁剪出一段<strong>90MM</strong>长度的短管，插入到<strong>底板连接件</strong>中，如图所示。
   
   
   
   
   
2.使用烙铁将三颗<strong>滚花螺母</strong>压入<strong>盖板连接件</strong>中，如图所示。
   
   

3.使用两颗<strong>M3*8 沉头螺丝</strong>将两片<strong>盖板打印件</strong>与<strong>盖板连接件</strong>进行锁紧，如图所示。
   
   
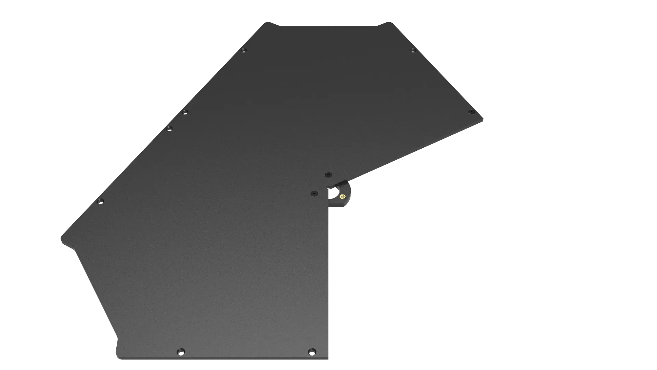
[picture p65: docs/delta/7/48.webp]
   

4.放入到打印机顶部，<strong>四氟管</strong>穿过<strong>盖板连接件</strong>，如图所示。
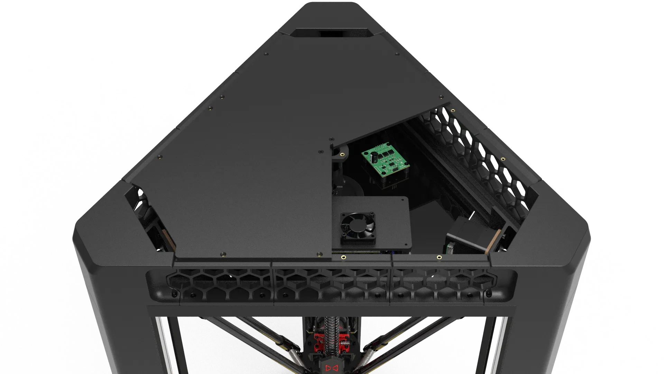
[picture p66: docs/delta/7/49.webp]
   

5.放入<strong>盖板打印件</strong>使用<strong>M3*8 沉头螺丝</strong>将<strong>盖板打印件</strong>与<strong>盖板连接件</strong>进行锁紧，如图所示。
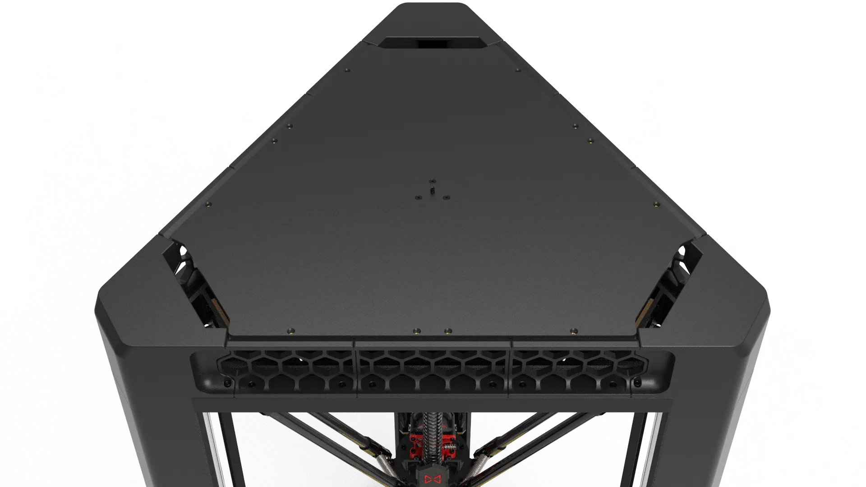
[picture p67: docs/delta/7/50.webp]
   

6.使用<strong>M3*8 沉头螺丝</strong>将所有<strong>盖板打印件</strong>锁紧，如图所示。
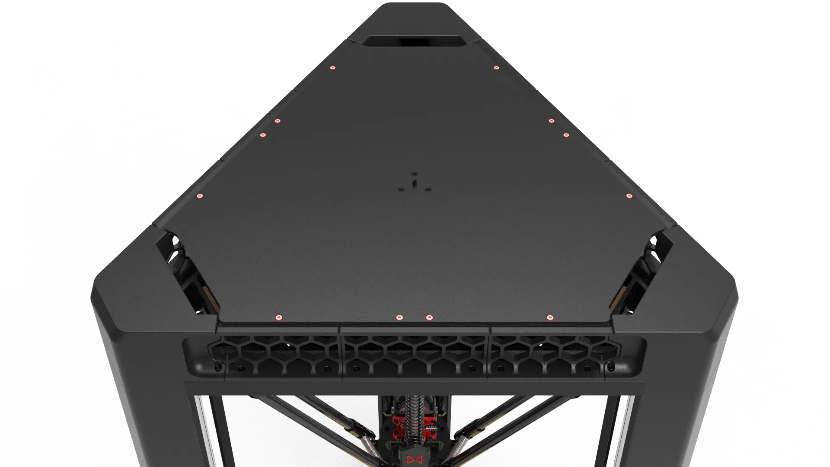
[picture p68: docs/delta/7/51.webp]
   
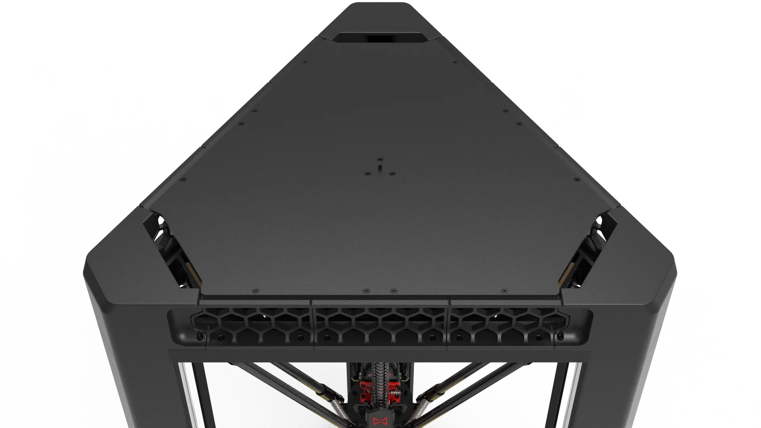
[picture p69: docs/delta/7/52.webp]
   

7.可将<strong>耗材支架</strong>放置在侧边或顶部，装置耗材，愉快打印。
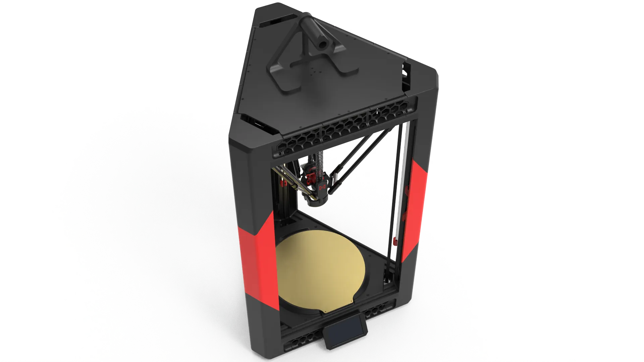
[picture p70: docs/delta/7/53.webp]
   
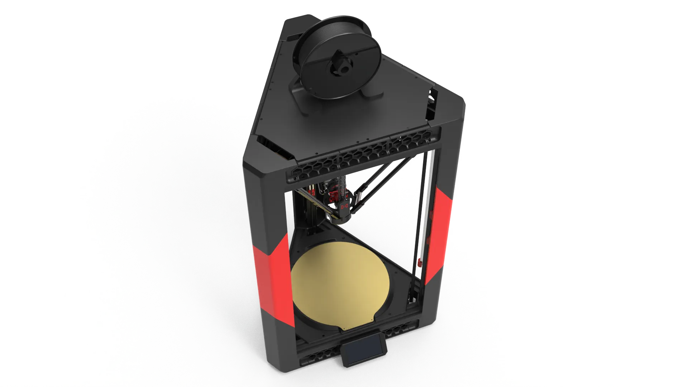
[picture p71: docs/delta/7/54.webp]
   

???- faq "FAQ"

    **Q: 为什么盖板连接件要这样设计？**

    **A:** 为保证高自由度和可复制性，所有的打印件均能本机完成打印，所以对设计进行了拆件，同时拆分后打印以及维护也将更加容易。

    **Q: 可以封箱么？**

    **A:** 可以，需要增加额外的材料和少量的改动即可实现封箱，不会损失任何打印尺寸，我将在完善后发布。
