cyberjak2k/micromake.github.io/docs/delta/5/5.md

---
title: 吊台组装
---

## 0.注意事项

!!! warning "螺丝固定"
    螺丝固定打印件时，不要拧的过紧，以免拧坏打印件。
    
    螺丝需要涂抹螺纹胶,  需要涂抹螺纹胶的螺丝使用<strong><span style="color:#295FCC">蓝色</span></strong>显示：
    
    
!!! info "嵌入螺母"
    部分打印件需借助烙铁压入<strong>滚花螺母</strong>：
    

???+ tip "安装建议"
    固定<strong>自锁螺母</strong>时，建议使用扳手辅助固定：
    
    没有螺纹的打印件,使用电动工具安装会更轻松：
    

## 1.热端组装

### 所需物料

1.金属吊台 * 1
   

2.金属球头连接件 * 3
   

3.打印头组件 * 1
   

4.四氟管 * 1
   

5.M2.5*6 杯头螺丝 * 4
   

6.M3*10 杯头螺丝 * 6
   

7.自锁螺母 * 6
   

### 组装流程

1.将两颗<strong>M3*10 杯头螺丝</strong>丝插入<strong>金属球头连接件</strong>中，如图所示。
   

2.<strong>M3*10 杯头螺丝</strong>需要涂抹螺纹胶，插入到<strong>金属吊台</strong>上，使用两颗<strong>自锁螺母</strong>锁紧。
   
   

3.请务必锁紧，可使用扳手进行辅助固定。
   
   

4.另外两组安装方法相同。
   

5.需要将四颗<strong>M2.5*6 杯头螺丝</strong>涂抹螺纹胶。
   
   
6.将<strong>四氟管</strong>裁剪出一段<strong>14MM</strong>长度的短管。
   

7.使用短管作为定位参考，如图所示将<strong>打印头组件</strong>与<strong>金属吊台</strong>连接。
   
   
8.使用四颗<strong>M2.5*6 杯头螺丝</strong>穿过<strong>金属吊台</strong>与<strong>打印头组件</strong>固定，需要拧紧。
   

9.将<strong>打印头组件</strong>的线穿过<strong>金属吊台</strong>，如图所示的孔中。
   

## 2.挤出组装

### 所需物料

1.挤出机背板 * 1
   

2.挤出机电机 * 1
   

3.POM齿轮 * 1
   

4.长光轴 * 1
   

5.短光轴 * 1
   

6.同步轮 * 1
   

7.顶丝 * 1
   

8.惰轮 * 1
   

9.弹簧 * 1
    

10.垫片 * 1
    

11.手拧螺丝 * 1
    

12.MR85轴承 * 2
    

13.滚针轴承 * 2
    

14.尼龙隔离柱 * 4
    

15.自锁螺母 * 6
    

16.滚花螺母 * 1
   

17.M3*14 杯头螺丝 * 2
    

18.M3*20 杯头螺丝 * 2
    

19.M3*35 圆头螺丝 * 2
    

### 打印零件

1.[挤出机打印件] * 1
[挤出机打印件]: dy1.stl
   

2.[挤出机扳手件] * 1
[挤出机扳手件]: dy2.stl
   

3.[波纹管固定件] * 1
[波纹管固定件]: dy3.stl
   

### 组装流程

1.将<strong>MR85轴承</strong>压入<strong>挤出机背板</strong>中，如图所示。
   
   

2.将<strong>同步轮</strong>穿入<strong>POM齿轮</strong>中，注意同步轮开孔的方向，如图所示。
   
   

3.使用<strong>顶丝</strong>涂抹上<strong>螺纹胶</strong>后拧紧顶丝，顶丝应在<strong>POM齿轮</strong>的平槽上，如图所示。
   
   
   

4.将<strong>MR85轴承</strong>穿入<strong>POM齿轮</strong>中，如图所示。
   

5.使用烙铁将<strong>滚花螺母</strong>压入<strong>挤出机打印件</strong>中，如图所示。
   
   

6.将<strong>POM齿轮</strong>与<strong>挤出机打印件</strong>连接，<strong>MR85轴承</strong>应卡在<strong>挤出机打印件</strong>的卡槽内，如图所示。
   
   

7.将<strong>POM齿轮</strong>与<strong>挤出机背板</strong>连接，<strong>POM齿轮</strong>应穿入<strong>挤出机背板</strong>的<strong>MR85轴承</strong>内，如图所示。
   
   

8.在<strong>挤出机背板</strong>与<strong>挤出机打印件</strong>之间的下方两个孔位放入两颗<strong>尼龙隔离柱</strong>使用两颗<strong>M3*20 杯头螺丝</strong>穿过并拧上<strong>自锁螺母</strong>，如图所示。
   
   
   
   

9.在<strong>挤出机背板</strong>与<strong>挤出机打印件</strong>之间的上方两个孔位放入两颗<strong>尼龙隔离柱</strong>使用两颗<strong>M3*35 杯头螺丝</strong>穿过，拧到<strong>挤出机电机</strong>上，穿过<strong>波纹管固定件</strong>并拧上<strong>自锁螺母</strong>，如图所示。
   
   
   
   
   
   

10.将两颗<strong>滚针轴承</strong>套入到<strong>短光轴</strong>内之后再套入<strong>同步轮</strong>，压入<strong>挤出机扳手件</strong>中，注意<strong>同步轮</strong>压入的方向，如图所示。
   
   
   
   
   
   

11.将<strong>长光轴</strong>穿过<strong>挤出机打印件</strong>与<strong>挤出机扳手件</strong>连接，如图所示。
   
   

!!! info "压入光轴"
       <strong>长光轴</strong>不易压入时，可使用电动工具扩夹住<strong>长光轴</strong>对<strong>挤出机打印件</strong>进行扩孔，不要硬压以免损坏<strong>挤出机打印件</strong>。

12.将两颗<strong>M3*14 杯头螺丝</strong>穿过<strong>挤出机打印件</strong>与<strong>金属吊台</strong>连接并拧上两颗<strong>自锁螺母</strong>，如图所示。
   
   
   

13.将<strong>手拧螺丝</strong>穿入<strong>弹簧</strong>与<strong>垫片</strong>，拧到<strong>挤出机打印件</strong>的<strong>滚花螺母</strong>上，如图所示。
   
   
   
   

## 3.风道组装

### 所需物料

1.M2.5*6 杯头螺丝 * 3
   

2.M3*10 杯头螺丝 * 3
   
   
3.M3*14 杯头螺丝 * 2
   

### 打印零件

1.[风道导向件]  * 1
[风道导向件]: dy4.stl
   

2.[风道连接件] * 1
[风道连接件]: dy5.stl
   

3.[风道固定件] * 1
[风道固定件]: dy6.stl
   

4.[堵风环] * 1
[堵风环]: dy7.stl
   

5.[风道件] * 1
[风道件]: dy8.stl
   

6.[吊台装饰件] * 1
[吊台装饰件]: dy9.stl
   

7.[吊台标识件] * 1
[吊台标识件]: dy10.stl
   
   
### 组装流程

1.将<strong>风道连接件</strong>卡住散热块，并使用<strong>M3*10 杯头螺丝</strong>穿过<strong>金属吊台</strong>进行固定，如图所示。
   
   
   

2.将<strong>吊台标识件</strong>压入到<strong>吊台装饰件</strong>中，如图所示。
   
   
   

3.将<strong>风道导向件</strong>放置到<strong>吊台装饰件</strong>下方，并使用两颗<strong>M3*14 杯头螺丝</strong>穿过，如图所示。
   
   
   
   

4.将两颗<strong>M3*14 杯头螺丝</strong>穿过<strong>金属吊台</strong>与<strong>风道连接件</strong>连接，拧好螺丝，如图所示。
   
   
   

5.将<strong>M3*14 杯头螺丝</strong>穿过<strong>金属吊台</strong>与<strong>风道固定件</strong>连接，拧好螺丝，如图所示。
   
   

!!! info "风道固定件"
       注意<strong>风道固定件</strong>的方向，较大的孔与<strong>M3*14 杯头螺丝</strong>固定。
       

6.将<strong>堵风环</strong>卡到<strong>风道件</strong>中，与<strong>风道连接件</strong>连接，如图所示。
   
   
   
   
   

7.使用三颗<strong>M2.5*6 杯头螺丝</strong>固定，拧好螺丝，如图所示。
   
   
   

## 4.线材整理

### 所需物料

1.波纹管 * 1
   

2.扎带 * 2
   

### 打印零件

1.[穿线器打印件] * 1
[穿线器打印件]: dy11.stl
   

### 组装流程

1.使用<strong>穿线器打印件</strong>将线材穿入<strong>波纹管</strong>中，如图所示。
   
   
   

2.将<strong>穿线器打印件</strong>卡入<strong>波纹管固定件</strong>的凹槽内并使用<strong>扎带</strong>扎紧，减去多余部分，如图所示。
   
   
   

## 5.连杆组装

### 所需物料

1.勺形连杆 * 6
   

2.拉力弹簧 * 6
   

### 组装流程

1.使用<strong>润滑脂</strong>涂抹到每个<strong>勺形连杆</strong>勺型孔中，保证配合时的运动顺滑，如图所示。
   

2.使用两个<strong>拉力弹簧</strong>将两个<strong>勺形连杆</strong>连接，如图所示。
   

3.拉动<strong>拉力弹簧</strong>，将两个<strong>勺形连杆</strong>卡入到如图所示位置。
   
   

4.另外两组连接方式相同，如图所示。
   

## 6.管线连接

### 所需物料

1.四氟管 * 1
   

### 打印零件

1.[管线卡扣] * 4
[管线卡扣]: dy12.stl
   

### 组装流程

1.将<strong>CPAP送风管</strong>安装到<strong>风道导向件</strong>上，如图所示。
   
   
   

2.将<strong>四氟管</strong>裁剪出一段20MM长度的短管。
   

!!! info "四氟管长度"
    此处<strong>四氟管</strong>长度并无严格限制20MM以上也可以。

3.使用短管插入到<strong>挤出机打印件</strong>中，避免耗材磨损打印件，如图所示。
   
   
   

4.将<strong>波纹管</strong>穿入<strong>底板连接件</strong>的小孔中，如图所示。
   
   

5.使用<strong>管线卡扣</strong>卡住<strong>CPAP送风管</strong>与<strong>波纹管</strong>，如图所示。
   
   

!!! info "管线卡扣"
    此处<strong>管线卡扣</strong>一般使用三到四个即可，起到美观作用，不打印也无影响。



???- faq "FAQ"

    **Q: 挤出机为什么这样设计？**

    **A:** 使用金属背板与电机固定起到一定散热作用，同时中间使用尼龙隔离柱隔离热量，挤出机采用一体打印，去除原有需要铜螺母与螺丝，降低装配难度提高装配精度（因为无需装配），同时得益于3D打印的优势使能改装与替换变得更加容易。

    **Q: 可以使用其他金属挤出机么？**

    **A:** 可以，孔位使用标准的Sherpa Mini挤出机孔位，可以使用全金属的Sherpa Mini、Sherpa micro、Lgx-lite等挤出机。

    **Q: Super Volcano会不会效果很差？**

    **A:** 我修改了Super Volcano的设计，将黄铜块改为了质量更轻的铝材料，同时喉管使用了TC4的钛合金喉管并进行了加粗，使强度更高，采用标准的V6喉管长度，减少了散热片的高度，经过长期测试效果并不是很差，同时因为喷嘴价格低廉更加适合长期使用。

    **Q: 可以更换其他加热块么？**

    **A:** 可以，使用标准E3DV6喉管，可以更换E3D V6、E3D Volcano与兼容E3D的环形加热块，从而可以选择更加多重种类的喷嘴，更换后可以使用CHT喷嘴。

    **Q: 可以更换整个更换么？**

    **A:** 可以，安装孔位与Voron V6兼容，可以使用大量Voron兼容的打印头。

    **Q: 可以更换风道件么？**

    **A:** 可以，我使用了Youtube的@NeedItMakeIt的导风罩设计挑战的孔位，所以在这场比赛中发布分享的所有导风模型均兼容。

    **Q: 可以安装独立散热风扇么？**

    **A:** 可以，我有预留孔位，可以加装独立喉管散热风扇，最初的设计本来就有，只是我解决了单风扇的问题，为了更高的打印速度，我舍弃了喉管散热风扇。
