cyberjak2k/micromake.github.io/docs/delta/7/dy2.stl

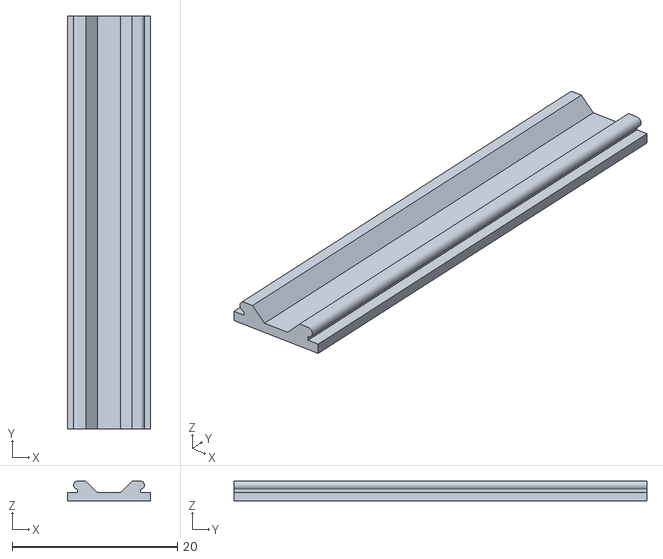
[picture p72: CAD file, 2026-03-05]
docs/delta/7/dy2.stl
10.0 x 50.0 x 2.40
