cyberjak2k/micromake.github.io/docs/delta/7/dy4.stl

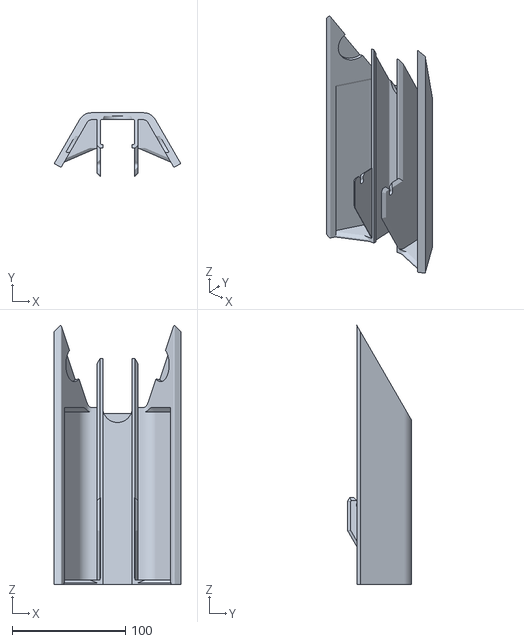
[picture p73: CAD file, 2026-03-05]
docs/delta/7/dy4.stl
111.8 x 56.1 x 228.7
