cyberjak2k/micromake.github.io/docs/delta/7/dy1.stl

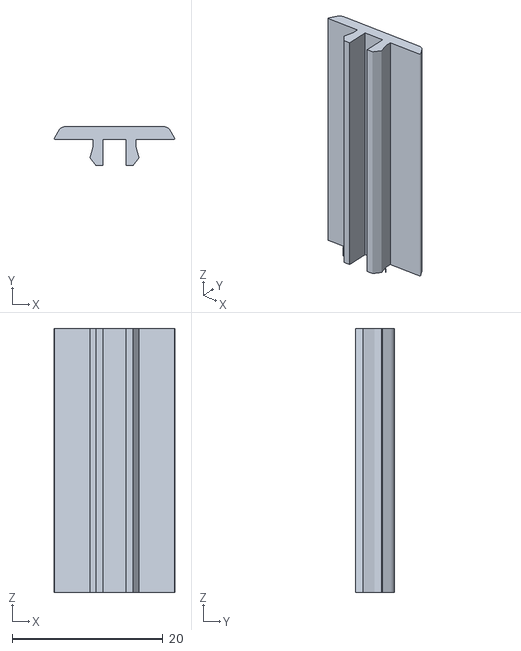
[picture p74: CAD file, 2026-03-05]
docs/delta/7/dy1.stl
16.0 x 5.14 x 35.0
