cyberjak2k/micromake.github.io/docs/delta/7/dy3.stl

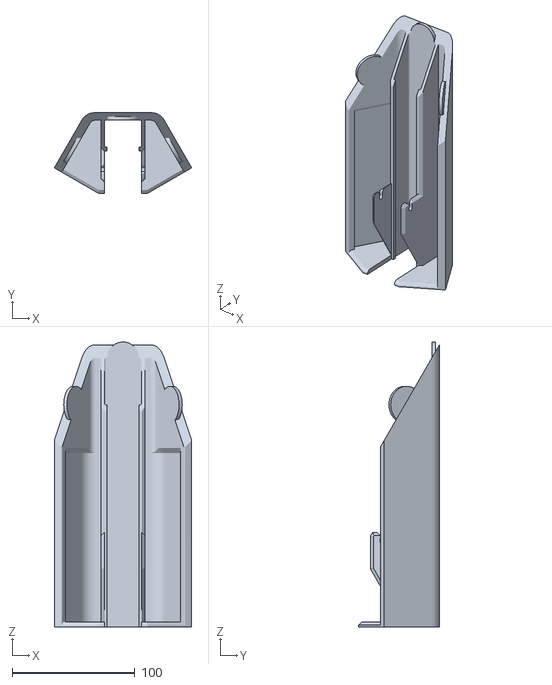
[picture p75: CAD file, 2026-03-05]
docs/delta/7/dy3.stl
111.8 x 65.6 x 231.8
