cyberjak2k/micromake.github.io/docs/delta/7/jxt.pdf

E
Z2

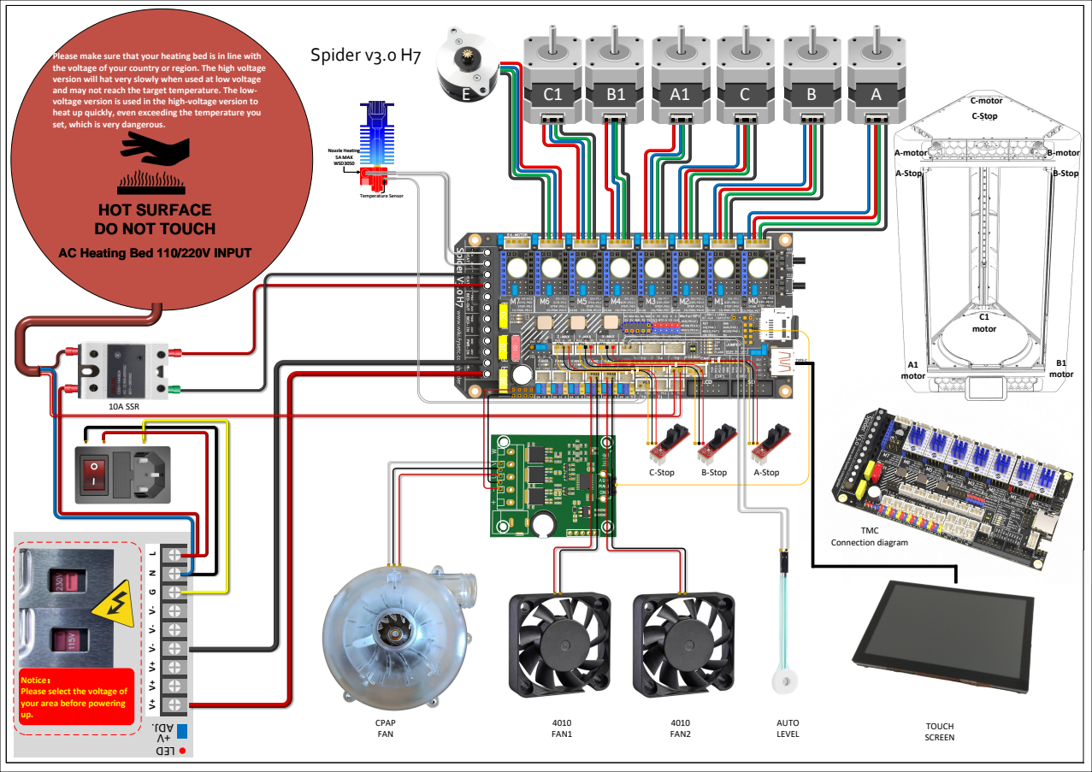
[picture p76: page 1]
LCD; Rear-Right; 10A SSR; Nozzle Heating 5A MAX WSD3050; Temperature Sensor; Spider v3.0 H7; CPAP FAN; 4010 FAN1; 4010 FAN2; C-Stop; B-Stop; A-Stop; AUTO LEVEL; TOUCH SCREEN; TYPE-C; A-motor; B-motor; C-motor; A1 motor; B1 motor; C1 motor; TMC Connection diagram

Please make sure that your heating bed is in line with
the voltage of your country or region. The high voltage
version will hat very slowly when used at low voltage
and may not reach the target temperature. The low-
voltage version is used in the high-voltage version to
heat up quickly, even exceeding the temperature you
set, which is very dangerous.

HOT SURFACE
DO NOT TOUCH

AC Heating Bed 110/220V INPUT

Notice：
Please select the voltage of
your area before powering
